RHSResearchLLC/PicoEVB/DMADriver/driver/readme.txt

The files in this directory provide Xilinx PCIe DMA drivers, example 
software, and example test scripts that can be used to exercise the 
Xilinx PCIe DMA IP. This software can be used directly or referenced 
to create drivers and software for your Xilinx FPGA hardware design.

Directory and file description:
 - driver/: This directory contains the Xilinx PCIe DMA kernel module
       driver files.
 - include/: This directory contain all include files that are needed
       for compiling driver.
 - etc/: This directory contains rules for the Xilinx PCIe DMA kernel
       module and software. The files in this directory should be
       copied to the /etc/ directory on your linux system.
 - tests/: This directory contains example application software to
       exercise the provided kernel module driver and Xilinx PCIe
       DMA IP. This directory also contains the following scripts 
       and directories.
   - load_driver.sh: This script loads the kernel module and creates
         the necissary kernel nodes used by the provided software.
         The The kernel device nodes will be created under /dev/xdma*.
         Additional device nodes are created under /dev/xdma/card* to
         more easily differentiate between multiple PCIe DMA enabled
         cards. Root permissions will be required to run this script.
   - run_test.sh: This script runs sample tests on a Xilinx PCIe DMA
         target and returns a pass (0) or fail (1) result. This 
         script is intended for use with the PCIe DMA example design.
   - data/: This directory contains binary data files that are used
         for DMA data transfers to the Xilinx FPGA PCIe endpoint 
         device.
   - scripts/: This directory contains test scripts that are
         referenced by the run_test.sh script.

Usage:
  - Change directory to the driver directory.
        cd driver
  - Compile the kernel module driver.
        make
  - Change directory to the tests directory.
        cd tests
  - Compile the provided example software.
        make
  - Copy the provided driver rules from the etc directory to the 
    /etc/ directory on your system.
        cp ../etc/udev/rules.d/* /etc/udev/rules.d/
  - Load the kernel module driver using the provided script.
        ./load_driver.sh
  - Run the provided test script to generate basic DMA traffic.
        ./run_test.sh

Updates and Backward Compaitiblity:
  - The following features were added to the PCIe DMA IP and driver 
    in Vivado 2016.1. These features cannot be used with PCIe DMA IP
    if the IP was generated using a Vivado build earlier than 2016.1.
      - Poll Mode: Earlier versions of Vivado only support interrupt
        mode which is the default behavior of the driver.
      - Source/Destination Address: Earlier versions of Vivado PCIe
        DMA IP required the low-order bits of the Source and 
        Destination address to be the same. As of 2016.1 this 
        restriction has been removed and the Source and Destination
        addresses can be any arbitrary address that is valid for
        your system.

Frequently asked questions:
  Q: How do I uninstall the kernel module driver?
  A: Use the following commands to uninstall the driver.
       - Uninstall the kernel module.
             rmmod -s xdma
       - Delete the dma rules that were added.
             rm -f /etc/udev/rules.d/60-xdma.rules
             rm -f /etc/udev/rules.d/xdma-udev-command.sh

  Q: How do I modify the PCIe Device IDs recognized by the kernel 
     module driver?
  A: The /driver/xdma-core.c file constains the pci_device_id struct 
     that identifies the PCIe Device IDs that are recognized by the
     driver in the following format:
         { PCI_DEVICE(0x10ee, 0x8038), },
     Add, remove, or modify the PCIe Device IDs in this struct as
     desired. Then uninstall the existing xdma kernel module, compile
     the driver again, and re-install the driver using the 
     load_driver.sh script.

  Q: By default the driver uses interupts to signal when DMA transfers
     are completed. How do I modify the driver to use polling rather
     than interrupts to determine when DMA transactions are completed?
  A: The driver can be changed from being interrupt driven (default)
     to being polling driven (poll mode) when the kernel module is
     inserted. To do this modify the load_driver.sh file as follows:
        Change: insmod ../driver/xdma.ko
        To:     insmod ../driver/xdma.ko poll_mode=1
     Note: Interrupt vs Poll mode will apply to all DMA channels. If 
     desired the driver can be modified such that some channels are 
     interrupt driven while others are polling driven. Refer to the 
     poll mode section of PG195 for additional information on using
     the PCIe DMA IP in poll mode. 

  Q: How can I enable debug in the kernel module driver to aid with
     driver development or debug?
  A: An XDMA_DEBUG define has been provided in the include/xdma-core.h
     file. To enable debug in the kernel module driver set this 
     #define to 1 as shown below.
         #define XDMA_DEBUG 1
     Then uninstall the existing xdma kernel module, compile the
     driver again, and re-install the driver using the load_driver.sh
     script.
