RHSResearchLLC/PicoEVB/images/pico-in-laptop-1_png_project-body-2.jpg

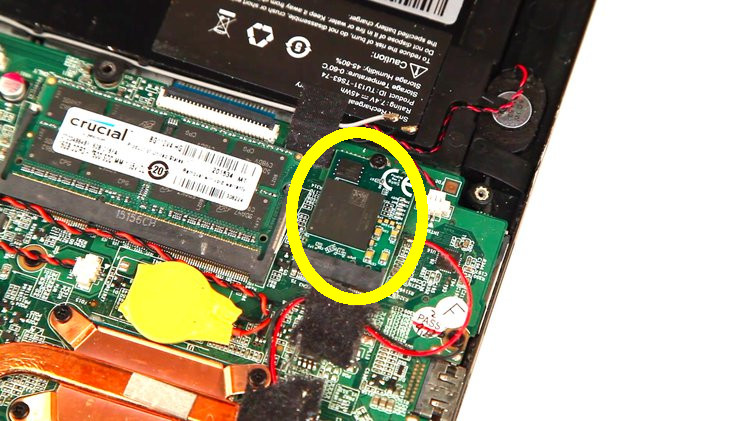
images/pico-in-laptop-1_png_project-body-2.jpg
