RHSResearchLLC/PicoEVB/images/vivado.png

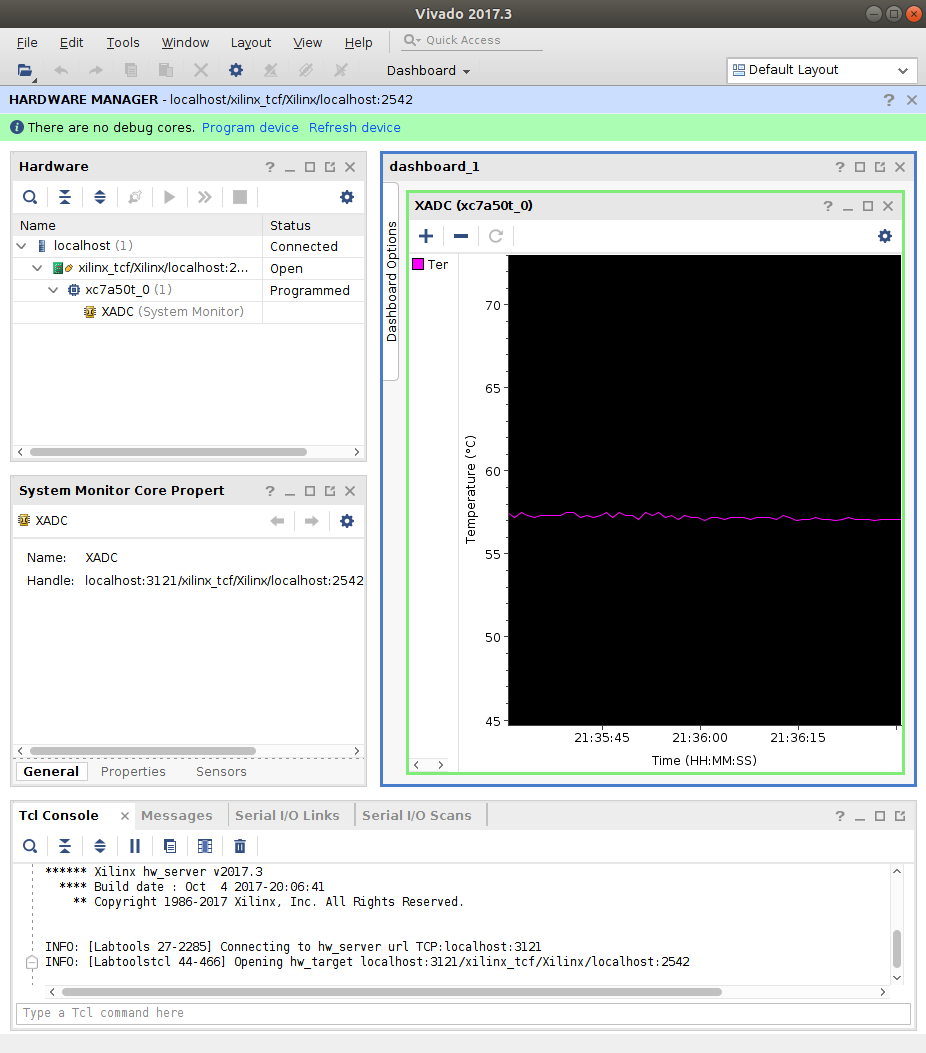
images/vivado.png
