RHSResearchLLC/PicoEVB/Hardware/board_design/PicoEVB.step

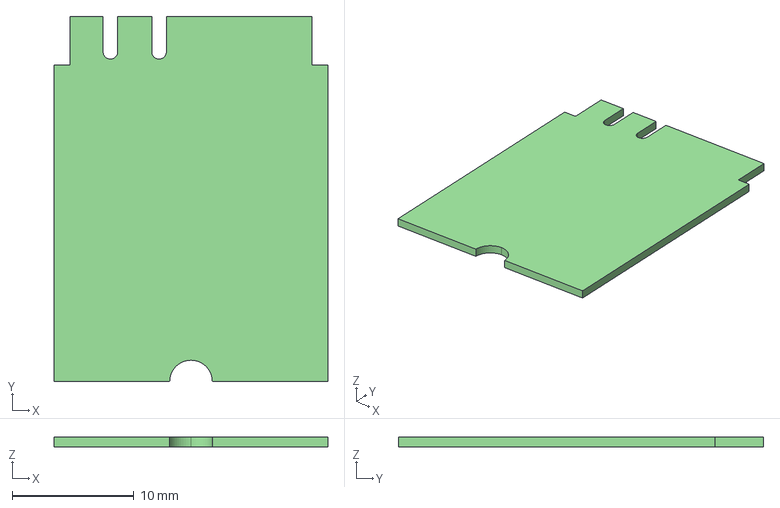
[picture p9: CAD file, 2025-12-04]
Hardware/board_design/PicoEVB.step
22.5 x 30.0 x 0.8 mm
