RHSResearchLLC/PicoEVB/(threads)

Thread 2 (2017-09-23):

Constraints map pin V11 - but it is N/C

joshrsmith, 2017-09-23:
Constraints map FPGA pin V11 to `status_leds[1]`, but this pin is NC in both picoEVB and nanoEVB.

RHSResearchLLC, 2018-01-12:
Fixed

Closed 2018-01-12.

Thread 4 (2018-01-02):

It would be great to add some samples how to use PicoEVB

hlide, 2018-01-02:
Now we have a Pico/NanoEVB, we may need some samples:

- How to read/write the host RAM through PCIe? suppose you want to make a guest [co]processor on the FPGA, you may want to reserve some host RAM for the guest [co]processor.
- How to share host RAM between guest (FPGA) and host (PC)?

RHSResearchLLC, 2018-01-09:
Hello hlide,

The Xilinx DMA core isn't exactly about sharing memory per se- its about transferring data between the host and FPGA at high speed. The Xilinx sample project has a good working demonstration of this and runs on NanoEVB/PicoEVB.

PCIe isn't really about shared memory, its about memory transfer. It seems shared because multiple clients can "access" it- but that access always consists of a transfer across the PCIe bus.

In your example (2), if the FPGA wants access to system RAM, it has to ask the PCIe system to transfer over a certain amount of data at a certain address. Likewise the FPGA can write into system RAM, but it still has to send a packet on the PCIe bus to do so. The FPGA has access to the RAM but it isn't like its a chip connected to the FPGA- you still need some real RAM in the FPGA to use as a reservoir.

The Xilinx DMA example demonstrates this:

- The host allocates some ram, and fills it with some data pattern.
- The host sends this data to the FPGA via PCIe; the data is transferred the data directly into the FPGA's BRAM
- The Host requests some data from the FPGA
- The FPGA transfers data from BRAM directly into host memory via PCIe

Granted the Xilinx example isn't super easy to follow. I could make a simpler, more explicit example.

hlide, 2018-01-11:
I know what DMA is and cannot be viewed as a direct RAM access. I asked you whether it was possible for the FPGA directly to address host RAM through PCIe before I decided to buy it (was my condition) and was kind of answered positively. But from what I can read above, there is no such possibility and a virtual RAM (a cache) is probably needed so the processor may not be impacted so much by the transfer timing between FPGA and Host through PCIe.

RHSResearchLLC, 2018-01-11:
Hello hlide,

It seems maybe I don't understand exactly what you mean. The FPGA does have
access to host memory. This access is implemented in Xilinx PCIe endpoint.
Xilinx provides an AXI interface to host memory. The sample project simply
transfers data from host memory to block ram. But you can make your own AXI
master to interface to Xilinx endpoint instead.

If you feel like you were deceived, or if this board can't do what you
need, shoot me an email (dave@nanoevb.com) so we can work it out. If you
want a refund, I will make good on it.

—
You are receiving this because you commented.
Reply to this email directly, view it on GitHub
<https://github.com/RHSResearchLLC/PicoEVB/issues/4#issuecomment-357039153>,
or mute the thread
<https://github.com/notifications/unsubscribe-auth/AbbnAI9F6OhpEP8PVvZU0J02MnlL0eSPks5tJmQ_gaJpZM4RQi_2>
.

hlide, 2018-01-11:
Suppose I want to add a soft processor with a virtual SRAM on the FPGA and that SRAM storage is provided by the host memory. So it is possible but you need a component which mimics an SRAM interface which is accessing the host memory through an AXI interface to host memory, right? So the issue is more with finding the right samples to show how to handle Xilinx endpoint to do that.

What I fear is there are no various samples which show how to program picoEMV for different tasks and so the product may remain unused. I had bought an MYIR Z-TURN ZYNQ 7020 long time ago and it remains in its box because there are no practical samples to learn how to use it efficiently in the end and I know several people in the same case with this board.

RHSResearchLLC, 2018-01-12:
Yes you are correct, you would need a component that has AXI on one side and SRAM-like interface on the other (with some type of wait signal to coordinate with the receipt of the data from the PCIe bus). I don't know of any samples out there that cover this.

hlide, 2018-01-12:
That's just an example.  I wonder if I can find a solution here: https://www.xilinx.com/products/intellectual-property/axi_pcie.html.

Thread 5 (2018-01-06):

Windows samples ?

hlide, 2018-01-06:
Seriously? that DMA sample for Linux is the only sample here?

RHSResearchLLC, 2018-01-09:
The DMA sample for Linux is only here because at the the time when this was developed, the version that Xilinx was hosting wouldn't build on Ubuntu-so I made some changes and hosted it here. Xilinx's code example builds on Windows, and works, no problem, as is.

https://www.xilinx.com/support/answers/65444.html

The DMA sample exercises the Xilinx DMA core in the HDL design. The HDL design also maps the physical I/O to registers-I'll be adding some host-side Python code soon to demonstrate that- but it is very simple.

What did you have in mind for sample projects?

hlide, 2018-01-11:
Mostly writing some processor cores, making some virtual computers - old systems or experimental systems (new cores). Incremental learning though. For this reason, I need to "steal" or share some resources like RAM to the host and some peripherals like storage and video may be on the host side (PC).

defparam, 2018-06-28:
Hi, I just posted an example of communicating to a PicoEVB device in Windows 10 using a UMDF2 driver example. Take a look here: https://github.com/defparam/BAR-Tender

RHSResearchLLC, 2018-06-28:
@defparam Very cool!

Thread 8 (2018-06-26):

Vivado board files

jeremytregunna, 2018-06-26:
I've looked high and low but I can't find any board files for the PicoEVB. Is this something planned or, not?

RHSResearchLLC, 2018-06-27:
Hi Jeremy,

Do you mean the PCB design files? If that is what you mean, I don't plan on releasing those. Besides the PCB, as designed, is a bit overkill (3 mil trace/space and via-in-pad) and expensive to manufacture.

jeremytregunna, 2018-06-27:
@RHSResearchLLC No I didn't mean the PCB design files, I meant the vivado specific files that would describe the board to Vivado such that it would show up in a list of boards when working in the design view to set up the clocks and external I/O

RHSResearchLLC, 2018-06-27:
@jeremytregunna Ahh OK. Sadly, I didn't know there was such a thing. That would be awesome. The closest thing I have is the [constraints file](https://github.com/RHSResearchLLC/PicoEVB/blob/master/Sample-Projects/Project-0/FPGA/constraints/xilinx_xdma_pcie_x0y0.xdc)

jeremytregunna, 2018-06-27:
@RHSResearchLLC Yeah I found that, and that's totally workable. I just went looking for board files while working on a test design for the new board (thanks btw, it's awesome for what it is). They're definitely not required just nice integration.

jeremytregunna, 2018-06-27:
Closing this then.

Closed 2018-06-27.

Thread 9 (2018-09-07):

Not able to connect using vivado Hardware manaager

shahbaazlokh, 2018-09-07:
Hello,

I have Picoevb attached to my motherboard via PCIe, I am not able to connect to it via Vivado Hardware manager. This is the message it shows.

WARNING: [Labtoolstcl 44-27] No hardware targets exist on the server [localhost:3121]
Check to make sure the cable targets connected to this machine are properly connected
and powered up, then use the refresh_hw_server command to re-register the hardware targets.

I am not able to understand this line in Readme file
First, make sure xvcd cable driver is running. Build the xvcd project, then run
`sudo ./xvcd -p 2542 -s i:0x0403:0x6015:0`

Please explain.
Thanks and Regards

shahbaazlokh, 2018-09-10:
Followed the steps guided in Readme file and the problem is solved,
Thanks

Closed 2018-09-10.

Thread 10 (2018-12-14):

Update on order status

fischer, 2018-12-14:
Hi,

On Dec 5, 2018 my Visa shows a debit for two PicoEVB boards that I ordered.  I didn't find any email confirming the order.  I didn't find an email with shipping information.  I didn't find a way to contact you via the picoevb.com website.  Can someone please post an email address so I can get an update on my order.

Thanks,

Todd Fischer
RidgeRun

Closed 2019-01-08.

Thread 11 (2019-02-13):

Copyright history of xilinx_xdma_pcie_x0y0.xdc

swarren, 2019-02-13:
The file PicoEVB/Sample-Projects/Project-0/FPGA/xilinx_xdma_pcie_x0y0.xdc contains:
## (c) Copyright 2012-2012 Xilinx, Inc. All rights reserved.

I'd like to create a project for PicoEVB, and want to re-use this .xdc file. However, I can't do it with the current license. Can you please tell me where you got the original file, and which parts you added yourself as opposed to found in the original, so I can research the licensing?

Thanks.

RHSResearchLLC, 2019-11-20:
Sorry for the extremely late response. Yes that file was autogenerated by Vivado, which it why the restrictive copyright. I was lazy and just copied their output and added PicoEVB-specific stuff.

The solution is to delete all the XDMA-specific stuff (Vivado makes its own constraint file for this anyway), and as such delete the copyright as well. When I update the project next I'll do this

swarren, 2019-11-20:
Thanks; that's what I figured. You might find https://github.com/NVIDIA/jetson-rdma-picoevb/tree/master/fpga useful as a reference; it allows using git with Vivado without having to check in all the generated stuff.

Closed 2020-07-22.

Thread 12 (2019-03-13):

Failed to detect XDMA config BAR

brooksbp, 2019-03-13:
I'm having trouble getting the sample project to work out of the box.

When using Xilinx_Answer_65444_Linux_Files_rel20180420.zip, I get this:

```
[635799.492540] xdma:xdma_mod_init: Xilinx XDMA Reference Driver xdma v2017.1.47
[635799.492542] xdma:xdma_mod_init: desc_blen_max: 0xfffffff/268435455, sgdma_timeout: 10 sec.
[635799.492563] xdma:xdma_device_open: xdma device 0000:04:00.0, 0x00000000fd37877b.
[635799.492564] xdma:alloc_dev_instance: xdev = 0x000000007df08759
[635799.492565] xdma:xdev_list_add: dev 0000:04:00.0, xdev 0x000000007df08759, xdma idx 0.
[635799.492642] xdma:pci_check_extended_tag: 0x00000000fd37877b EXT_TAG disabled.
[635799.492643] xdma:pci_check_extended_tag: pdev 0x00000000fd37877b, xdev 0x000000007df08759, config bar UNKNOWN.
[635799.492650] xdma:request_regions: pci_request_regions()
[635799.492652] xdma:map_single_bar: BAR0: 1048576 bytes to be mapped.
[635799.492679] xdma:map_single_bar: BAR0 at 0xdf300000 mapped at 0x00000000a16149d0, length=1048576(/1048576)
[635799.492683] xdma:is_config_bar: BAR 0 is NOT the XDMA config BAR: 0xffffffff, 0xffffffff.
[635799.492683] xdma:map_single_bar: BAR2: 65536 bytes to be mapped.
[635799.492691] xdma:map_single_bar: BAR2 at 0xdf400000 mapped at 0x0000000095d37002, length=65536(/65536)
[635799.492694] xdma:is_config_bar: BAR 2 is NOT the XDMA config BAR: 0xffffffff, 0xffffffff.
[635799.492695] xdma:map_bars: Failed to detect XDMA config BAR
[635799.517276] xdma: probe of 0000:04:00.0 failed with error -22
```

How could reading the config registers (PG195) from the BAR fail and return all ones?

brooksbp, 2019-03-15:
After programming the bitstream, I had to:

```
# echo 1 > /sys/bus/pci/devices/0000\:03\:00.0/remove
# echo 1 > /sys/bus/pci/rescan
```

Previously, I was just doing the rescan without removing the device. Removing the device before the rescan is necessary.

makslevental, 2022-02-07:
Not sure why it occurred for @brooksbp but it occurs for me as well when I ditch the xadc module. Luckily someone has had this same issue and posted about it over on the [Xilinx forums](https://support.xilinx.com/s/question/0D52E00006hpQezSAE/config-bar-not-detected-in-xdma-driver?language=en_US). Since Xilinx's forums have spotty uptime (and sometimes the posts straight up vanish), I'm copy+pasting here:

 >[dakota111](https://support.xilinx.com/s/profile/0052E00000N3gJNQAZ) (Customer)

9 months ago
**BEST SOLUTION**
Ok, so I THINK I have an idea why BAR2 IRQ ID is returning all 0xF. If you have time to try it out, please let me know how it works out.
I modified the picoevb image to remove the XADC block because I did not want it.
The side effect of that was now there is no valid block behind 0x3000 on the AXI lite bus (BAR0).
When the XDMA driver reads ID registers to figure out what BAR is the config BAR, it does it in the following order:
* BAR0 IRQ ID at BAR0\+0x2000: access to axi_gpio_1 successfully
* BAR0 CFG ID at BAR0\+0x3000: access to NULL fails
* BAR2 IRQ ID at BAR0\+0x2000: access to xdma reg BUT returns invalid value from NULL read
* BAR2 CFG ID at BAR0\+0x3000: access to xdma reg successfully
To fix this, I modifed xdma/libxdma.c to read BAR2 IRQ ID twice to flush out the error

Closed 2019-03-15.

Thread 13 (2019-05-14):

(Sample project) Updating IPs leads to a failure in communication with the PicoEVB

CedricDly, 2019-05-14:
Hi,
I'm facing an issue when I try to compile and use the Sample Project given in the Github repository. When opening the project in Vivado 2018.3, the IP Upgrade results in a Critical Warning, telling me to look at a log file in order to fix. Here is the warning section of the log:

```
2. Customization warnings
-------------------------

Parameter 'pf1_expansion_rom_size_mqdma' is no longer present on the upgraded IP 'project_bd_xdma_0_0', and cannot be set to '2'
Parameter 'pf0_expansion_rom_size_mqdma' is no longer present on the upgraded IP 'project_bd_xdma_0_0', and cannot be set to '2'
Parameter 'pf2_expansion_rom_enabled_mqdma' is no longer present on the upgraded IP 'project_bd_xdma_0_0', and cannot be set to 'false'
Parameter 'pf1_expansion_rom_enabled_mqdma' is no longer present on the upgraded IP 'project_bd_xdma_0_0', and cannot be set to 'false'
Parameter 'pf0_expansion_rom_scale_mqdma' is no longer present on the upgraded IP 'project_bd_xdma_0_0', and cannot be set to 'Kilobytes'
Parameter 'pf2_expansion_rom_scale_mqdma' is no longer present on the upgraded IP 'project_bd_xdma_0_0', and cannot be set to 'Kilobytes'
Parameter 'pf0_expansion_rom_enabled_mqdma' is no longer present on the upgraded IP 'project_bd_xdma_0_0', and cannot be set to 'false'
Parameter 'pf3_expansion_rom_type_mqdma' is no longer present on the upgraded IP 'project_bd_xdma_0_0', and cannot be set to 'N/A'
Parameter 'pf2_expansion_rom_type_mqdma' is no longer present on the upgraded IP 'project_bd_xdma_0_0', and cannot be set to 'N/A'
Parameter 'pf1_expansion_rom_type_mqdma' is no longer present on the upgraded IP 'project_bd_xdma_0_0', and cannot be set to 'N/A'
Parameter 'pf0_expansion_rom_type_mqdma' is no longer present on the upgraded IP 'project_bd_xdma_0_0', and cannot be set to 'N/A'
Parameter 'pf1_expansion_rom_scale_mqdma' is no longer present on the upgraded IP 'project_bd_xdma_0_0', and cannot be set to 'Kilobytes'
Parameter 'pf3_expansion_rom_scale_mqdma' is no longer present on the upgraded IP 'project_bd_xdma_0_0', and cannot be set to 'Kilobytes'
Parameter 'pf3_expansion_rom_size_mqdma' is no longer present on the upgraded IP 'project_bd_xdma_0_0', and cannot be set to '2'
Parameter 'pf3_expansion_rom_enabled_mqdma' is no longer present on the upgraded IP 'project_bd_xdma_0_0', and cannot be set to 'false'
Parameter 'pf2_expansion_rom_size_mqdma' is no longer present on the upgraded IP 'project_bd_xdma_0_0', and cannot be set to '2'
```

Despite this critical warning, the bitstream is compiled but when flashed to the PicoEVB, it does not work as it should. Here is a result of the "xdma_info" command:
```
Found 1 XDMA devices
device path:    \\?\pci#ven_10ee&dev_7021&subsys_000710ee&rev_00#4&97078f1&0&00e4#{74c7e4a9-6d5d-4a70-bc0d-20691dff9e9d}
unknown Module
unknown Module
unknown Module
unknown Module
unknown Module
unknown Module
unknown Module
```

Any advice on how to solve this issue ? Should I downgrade my Vivado version ?

jackpot51, 2019-09-25:
I would also like to know how to update the sample project successfully - I am on Vivado 2019.1.3

Hallb3rg, 2019-10-07:
I'm also struggling with this a bit now.

The critical warning messages seem to come from a name change of a variable, and may be unrelated.

In Windows the "unknown module" is resolved after either re-installing the driver or rebooting the PC.
In case the power is cycled on the PCIe card during reboot you need to make sure you have written the bitstream to flash.
After this the xdma_info worked....almost....

Now I get data mismatch running the DMA tests ( in both Linux and windows).
Sometimes xdma_info stops working again, and Windows crashes completely.
I'm thinking it may be timing related since it is just some of the data that is wrong, and at different positions each run.

Hugh3226, 2019-11-06:
I'm struggling too.
Have tried Vivado 2017.3 and 2019.1

Vivado v2017.3 (64-bit)
SW Build: 2018833 on Wed Oct 4 19:58:22 MDT 2017
IP Build: 2016188 on Wed Oct 4 21:52:56 MDT 2017

Vivado v2019.1 (64-bit)
SW Build: 2552052 on Fri May 24 14:49:42 MDT 2019
IP Build: 2548770 on Fri May 24 18:01:18 MDT 2019

RHSResearchLLC, 2019-11-20:
I'm working on updated sample project which uses Vivado 2019, and Xilinx latest drivers (https://github.com/Xilinx/dma_ip_drivers). This sample project will also have a tool to program the flash over PCIe, which is much faster. Stay tuned

RHSResearchLLC, 2019-11-21:
OK latest design (EVB4) fixes these problems. Issue is Xilinx "new" driver doesn't like "user" stuff at low addresses. Moved I/O addresses up to 0x1000 and higher.

Closed 2019-11-21.

Thread 14 (2019-09-25):

Extremely long programming time

langfordpang, 2019-09-25:
I'm having trouble programming MCS file to flash. Basically, after I run prog-fpga.tcl, it takes more than 8 hrs *elapsed time* to program the flash, while the *CPU time* is just a few minutes. I am not even sure if the flash is correctly programmed after 8 hrs because all I have right now is the MCS file from the master branch, which I believe is the same one as default.

I am using CentOS 7.6 and Vivado 2018.3, which I don't believe makes a difference in this case. I thought about other possibilities are USB device busy(?) or JTAG speed too low(?) but none of them make sense. I cannot explain. Please advise.

langfordpang, 2019-09-25:
Follow up on this issue -
1) tried another image using different chip ID and confirmed the image can be successfully programmed. But it takes the same amount of time (8+hrs)
2) while building XVCD, it failed to find function ftdi_write_data_async. I searched in the header file and library and no such a symbol. I also failed to find a reliable source online to build myself. So I removed the ASYNC macro. I guess this could be the reason. If it’s true, can you advise how I should get over this? Thank you.

RHSResearchLLC, 2019-11-20:
Normal programming time is 20 minutes, which isn't great but better than 8hr. You can try an executable I pre-built for Linux: https://github.com/RHSResearchLLC/xvcd/blob/master/linux/bin/xvcd

It depends on a few libraries:
```
linux-vdso.so.1 (0x00007fffe7969000)
	libftdi.so.1 => /usr/lib/x86_64-linux-gnu/libftdi.so.1 (0x00007f32c195f000)
	libc.so.6 => /lib/x86_64-linux-gnu/libc.so.6 (0x00007f32c156e000)
	libusb-0.1.so.4 => /lib/x86_64-linux-gnu/libusb-0.1.so.4 (0x00007f32c1365000)
	/lib64/ld-linux-x86-64.so.2 (0x00007f32c1d6b000)
```

resinbeard, 2019-12-18:
As a data point, my programming time takes 28min

RHSResearchLLC, 2020-11-30:
Just added https://github.com/RHSResearchLLC/PicoEVB/tree/master/spi-flash-program-openocd. This can program the entire flash in under 5 minutes. The sample project programs in 2 minutes.

makslevental, 2022-02-05:
@RHSResearchLLC sorry for the n00b question, but for our own projects, what do we replace in `flash.cfg`? i.e. here

```
jtagspi_init 0 bscan_spi_xc7a50t.bit
jtagspi_program image.bin 0x0
```
do we replace `bscan_spi_xc7a50t.bit` or `image.bin` with the corresponding files produced by vivado? I actually tried both permutations and replacing `bscan_spi_xc7a50t.bit` got me the same behavior as the example, and the inverse didn't successfully flash.

RHSResearchLLC, 2022-02-09:
You'd replace image.bin with an output from vivado- flash image in binary
format

On Sat, Feb 5, 2022 at 2:57 PM Maksim Levental ***@***.***>
wrote:

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

Thread 15 (2019-10-29):

Not coming out of reset on ARM (iMX6) devices

AndyCapp69, 2019-10-29:
I have tried the PicoEVB in several different types of iMX6 and the PicoEVB never comes out of reset (all LEDS on constant). I have tried modifying the PCI driver (pci-imx6.c) to extend the delays for clock stabilisation etc and even tried inverting the reset signal.  Using a scope I can see the reset line is being controlled. It does work on a Linux or Windows PC. Has anybody ever seen this working on an ARM system?

tschaar, 2019-10-29:
I have the PicoEVB working successfully with a Jetson Xavier dev kit.

Hugh3226, 2019-11-06:
I had the same problem.
The motherboard I use had an inverting open drain transistor on the reset line. Also a 100K pull-up and 22pF capacitor to deck.
I removed the capacitor and reduced the pull-up to 1K ohm.
We are using an iMX6.
Regards

RHSResearchLLC, 2019-11-20:
Thanks for reporting

Closed 2019-11-20.

Thread 16 (2019-11-21):

pcie recognition problems

starkten, 2019-11-21:
I've recently bought the PicoEVB board and adapter to connect it via mPCIe port. Right now I'm trying to program ARTIX with my own project being written through xapp1052, but I have some difficulties with misunderstanding output signal behavior as i use verilog ordinary. Is it neccessary to use W_DISABLE0, W_DISABLE1 placed on 56 and 54 pins of M2 port or should PC recognise PCIe device without it correctly? Thanks for your help.

RHSResearchLLC, 2019-11-26:
Hello starkten,
The W_DISABLE0 and W_DISABLE1 pins are simply input to the FPGA- they have no impact on FPGA/PCIe recognition and can be ignored.

The factory bitstream doesn't work well with the latest Xilinx drivers. If you are using Xilinx drivers from their GitHub, please load new bitstream 'EVB4' from https://github.com/RHSResearchLLC/PicoEVB/tree/master/Sample-Projects/Project-0/FPGA/mcs.

If you are using the "old" drivers (like the drivers I forked), the factory bitstream should work fine.

Closed 2020-01-16.

Thread 17 (2020-06-10):

SPI NOR Flash "S25FL132K0XNFIQ11" obsolete?

LuckyPi, 2020-06-10:
The SPI NOR Flash "S25FL132K0XNFIQ11" included in the BOM is showing as obsolete on Mouser & Digi-Key.  Do you have a recommended alternative that will work with the sip-loader? Thanks!

RHSResearchLLC, 2020-06-13:
I have a large cache of S25FL123K, so for the next year (at least) PicoEVB will be built with this flash. If I do change the flash part, I'll update spi-loader to support the new flash.

There are several flash parts that work with the XC7A50T part. See Xilinx UG908 appendix C.

Closed 2020-06-13.

Thread 18 (2020-07-22):

spi_loader fails on verify

RHSResearchLLC, 2020-07-22:
SPI loader successfully writes flash, but fails on verify phase. spi_loader needs to be fixed to account for dummy cycles on read

p0llard, 2020-07-25:
Out of interest, does this occur at random, or is there a reliable way to reproduce this issue? I've been using the `spi_loader` program quite a bit without any issues,

RHSResearchLLC, 2020-07-25:
It appears that the code does indeed account for dummy cycles on read. Not sure what i was thinking.

Thread 19 (2021-11-10):

Example Program doesn't appear to work

lucasbanting, 2021-11-10:
The example program appears to have been update to vivado 2020.1.
Vivado 2020.1 has a bug: https://support.xilinx.com/s/article/75502?language=en_US

When I try to generate the block design for the sample project, I get the error:
[BD 41-237] Bus Interface property FREQ_HZ does not match between /xadc_wiz_0/s_axi_lite(100000000) and /axi_interconnect_0/xbar/M02_AXI(125000000)

Which appears to be related to the aforementioned Vivado bug. Does anyone have a currently working configuration they are using that works with the sample project?

RHSResearchLLC, 2021-11-13:
I haven't yet updated the project to Vivado 2021. If you open in Vivado 2021, it should auto-update.

lucasbanting, 2021-11-16:
For what it is worth I am running on an unsupported OS, but after pulling the last git commit 3 days ago I can now synthesize the project successfully. I am using vivado 2021.2, not 2021.1.

The only message I found when upgrading the IP's was:

2. Customization warnings
-------------------------

An attempt to modify the value of disabled parameter 'pf1_msix_cap_table_size' from '000' to '01F' has been ignored for IP 'project_bd_xdma_1_0'

An attempt to modify the value of disabled parameter 'pf1_msix_cap_table_offset' from '00000000' to '00009000' has been ignored for IP 'project_bd_xdma_1_0'

An attempt to modify the value of disabled parameter 'pf1_msix_cap_pba_offset' from '00000000' to '00009FE0' has been ignored for IP 'project_bd_xdma_1_0'

Should these be values be re-customized to remove the warning?

Thread 21 (2022-04-10):

Mating connector for 6-pin digital interface

FlashPackets, 2022-04-10:
Please provide a part number for the 6-pin digital interface.

FlashPackets, 2022-04-10:
Found it in the board docs. Molex Pico-EZMate

Thread 22 (2024-11-16):

Key type?

Erhannis, 2024-11-16:
I'm pretty new to M.2 devices, so maybe I have a fundamental misunderstanding here, but: how hard would it be to make this fit an m key slot?  I have a new laptop, saw it had two extra M.2 2230 slots, and thought, "Oh, maybe I'll put something cool in one, like an FPGA."  The laptop documentation didn't say what key type they were (though people in-the-know may have noticed it was in the "storage" section of the documentation), couldn't find anything about it, so I figured key type must be one of those things that doesn't matter much in practice.  Bought a PicoEVB off Amazon.  Nope!  Doesn't fit.  Apparently I can _replace my wifi card_ with it, but haha, I need my wifi card.  How difficult would it be to refactor the card to fit an m key slot?  A matter of moving a few pins, of swapping around some components, of redesigning the entire board, or of subverting the entire system of M.2 types?
