RHSResearchLLC/PicoEVB/Hardware/PicoEVB-D.pdf

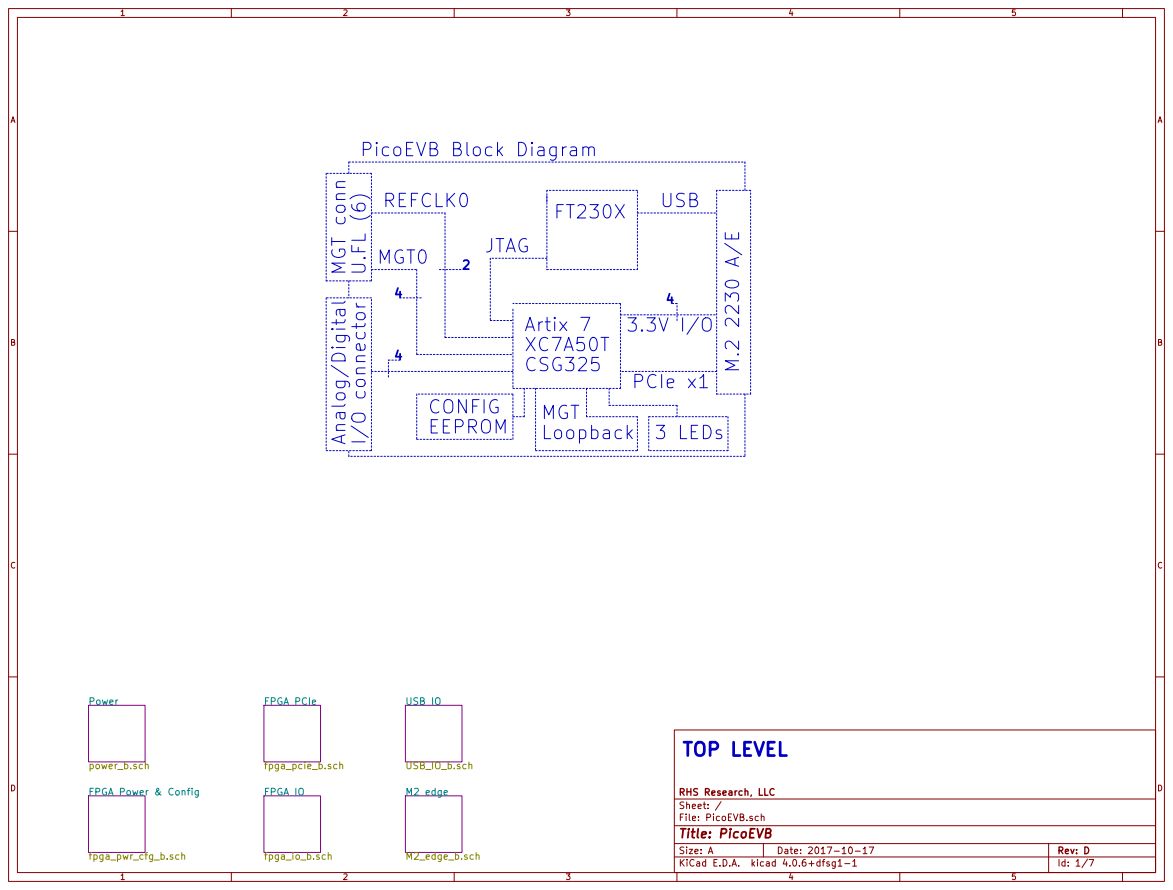
[picture p10: page 1]

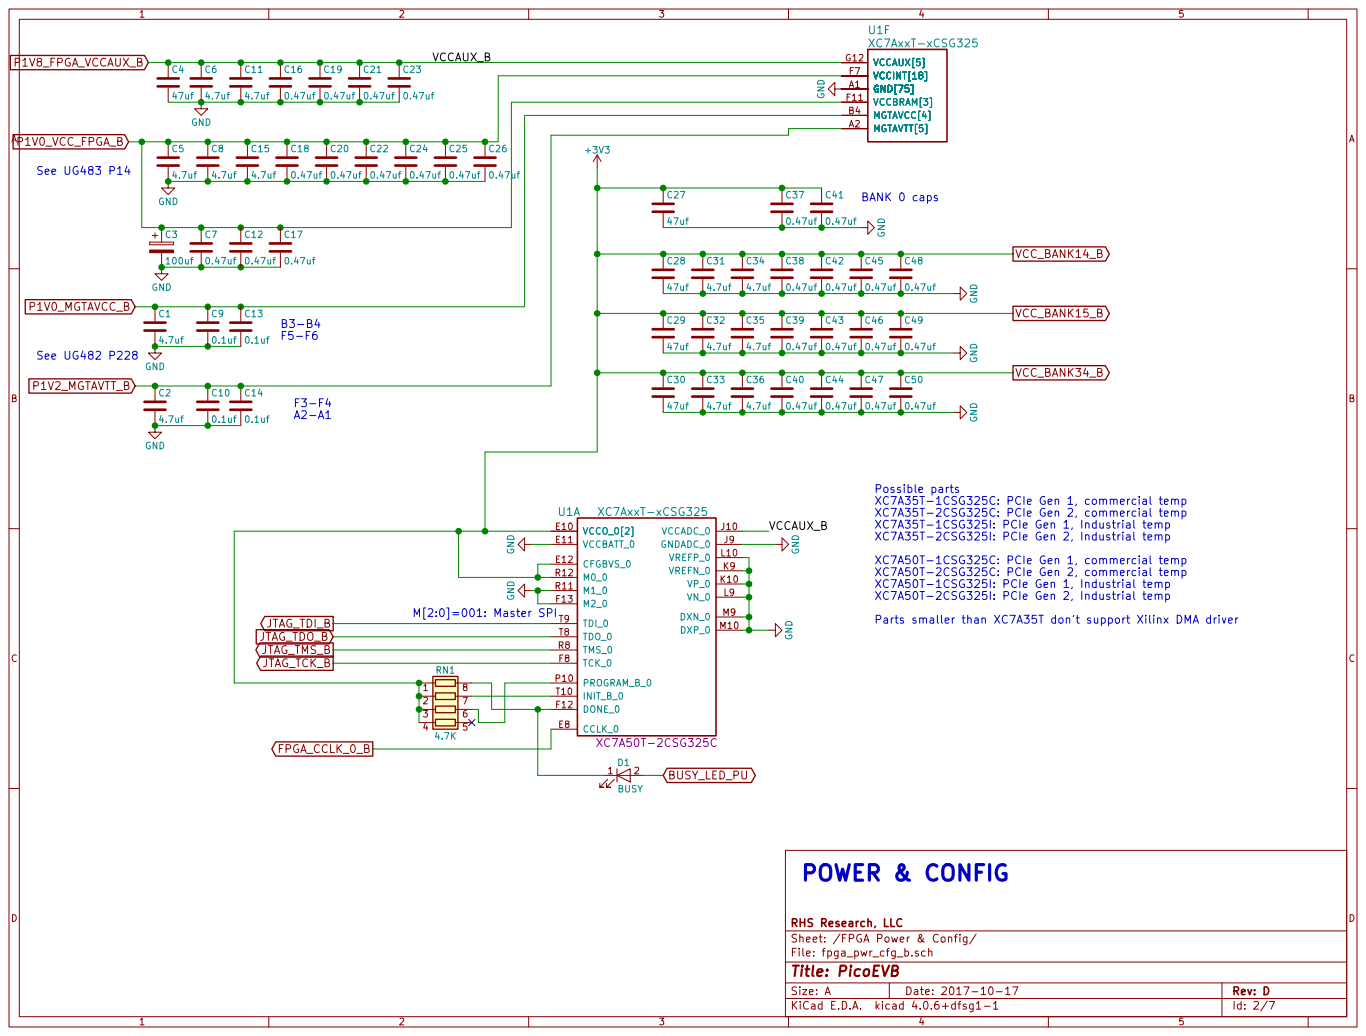
[picture p11: page 2]

+3V3 GND GND GND GND

Possible parts
XC7A35T-1CSG325C: PCIe Gen 1, commercial temp
XC7A35T-2CSG325C: PCIe Gen 2, commercial temp
XC7A35T-1CSG325I: PCIe Gen 1, Industrial temp
XC7A35T-2CSG325I: PCIe Gen 2, Industrial temp
XC7A50T-1CSG325C: PCIe Gen 1, commercial temp
XC7A50T-2CSG325C: PCIe Gen 2, commercial temp
XC7A50T-1CSG325I: PCIe Gen 1, Industrial temp
XC7A50T-2CSG325I: PCIe Gen 2, Industrial temp
Parts smaller than XC7A35T don't support Xilinx DMA driver

RHS Research, LLC
Sheet: /FPGA Power & Config/
File: fpga_pwr_cfg_b.sch
Id: 2/7 Title: PicoEVB

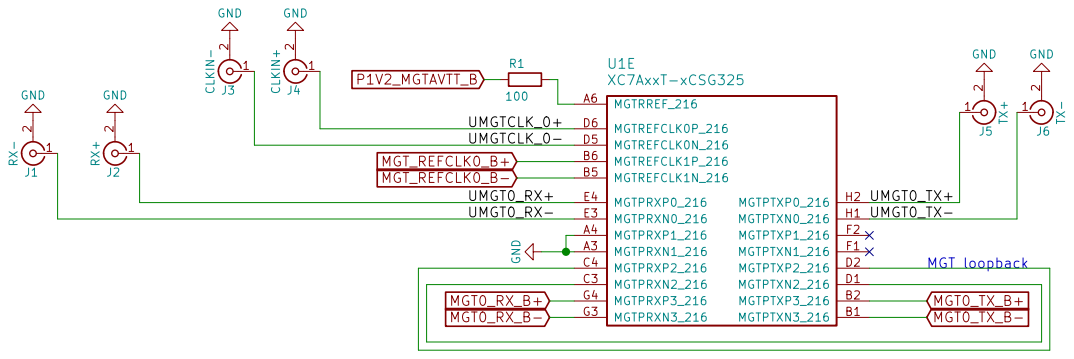
[picture p12: page 3]

PCI Express / MGT loopback

File: fpga_pcie_b.sch Sheet: /FPGA PCIe/ RHS Research, LLC

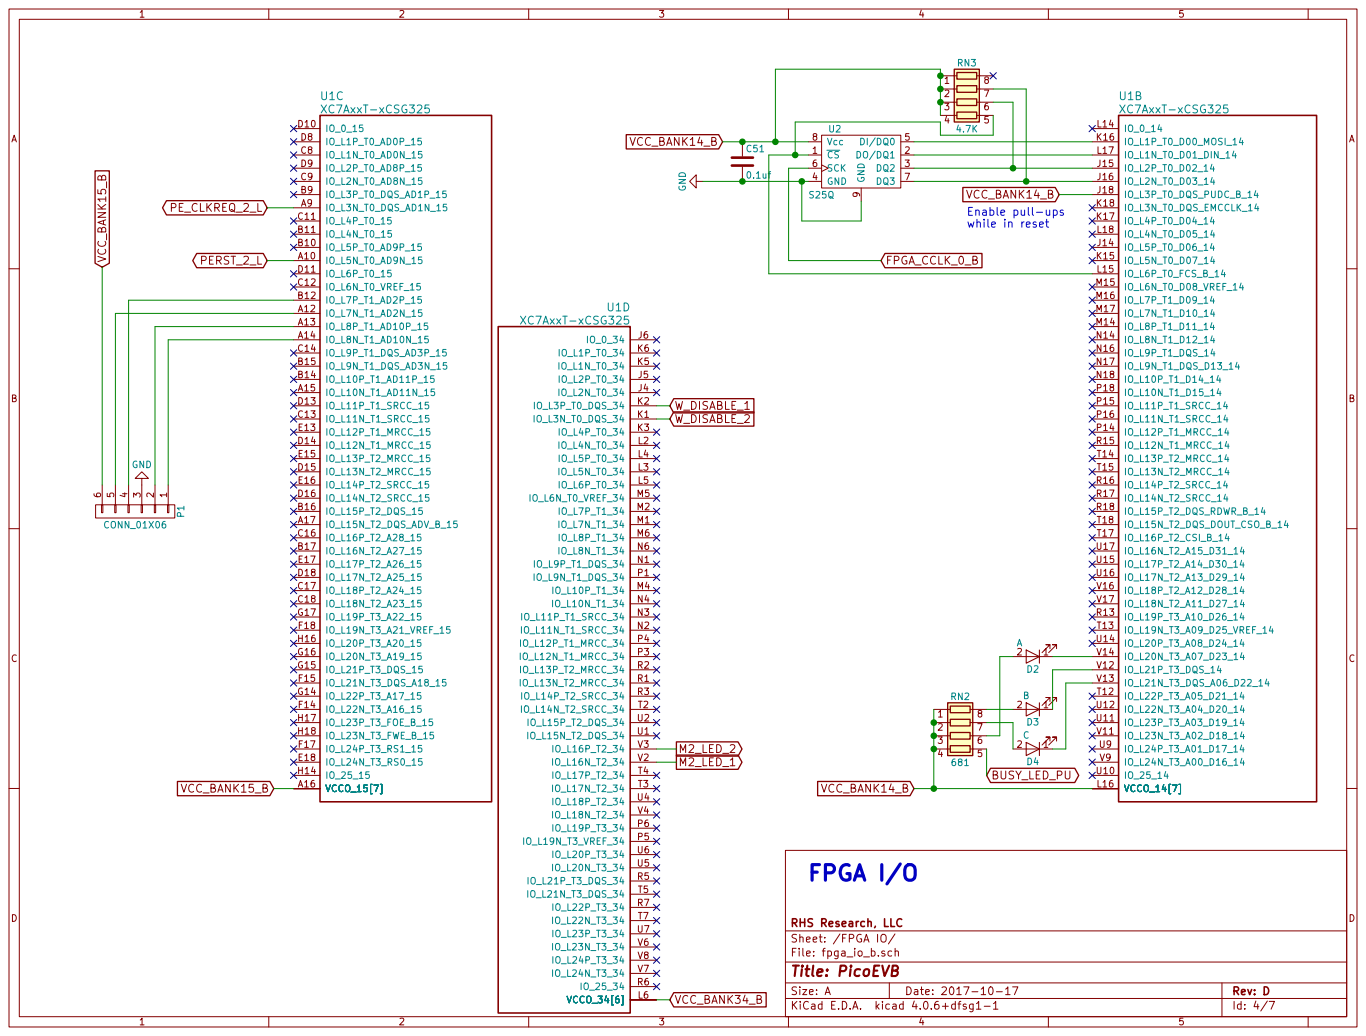
[picture p13: page 4]

File: fpga_io_b.sch Sheet: /FPGA IO/ RHS Research, LLC

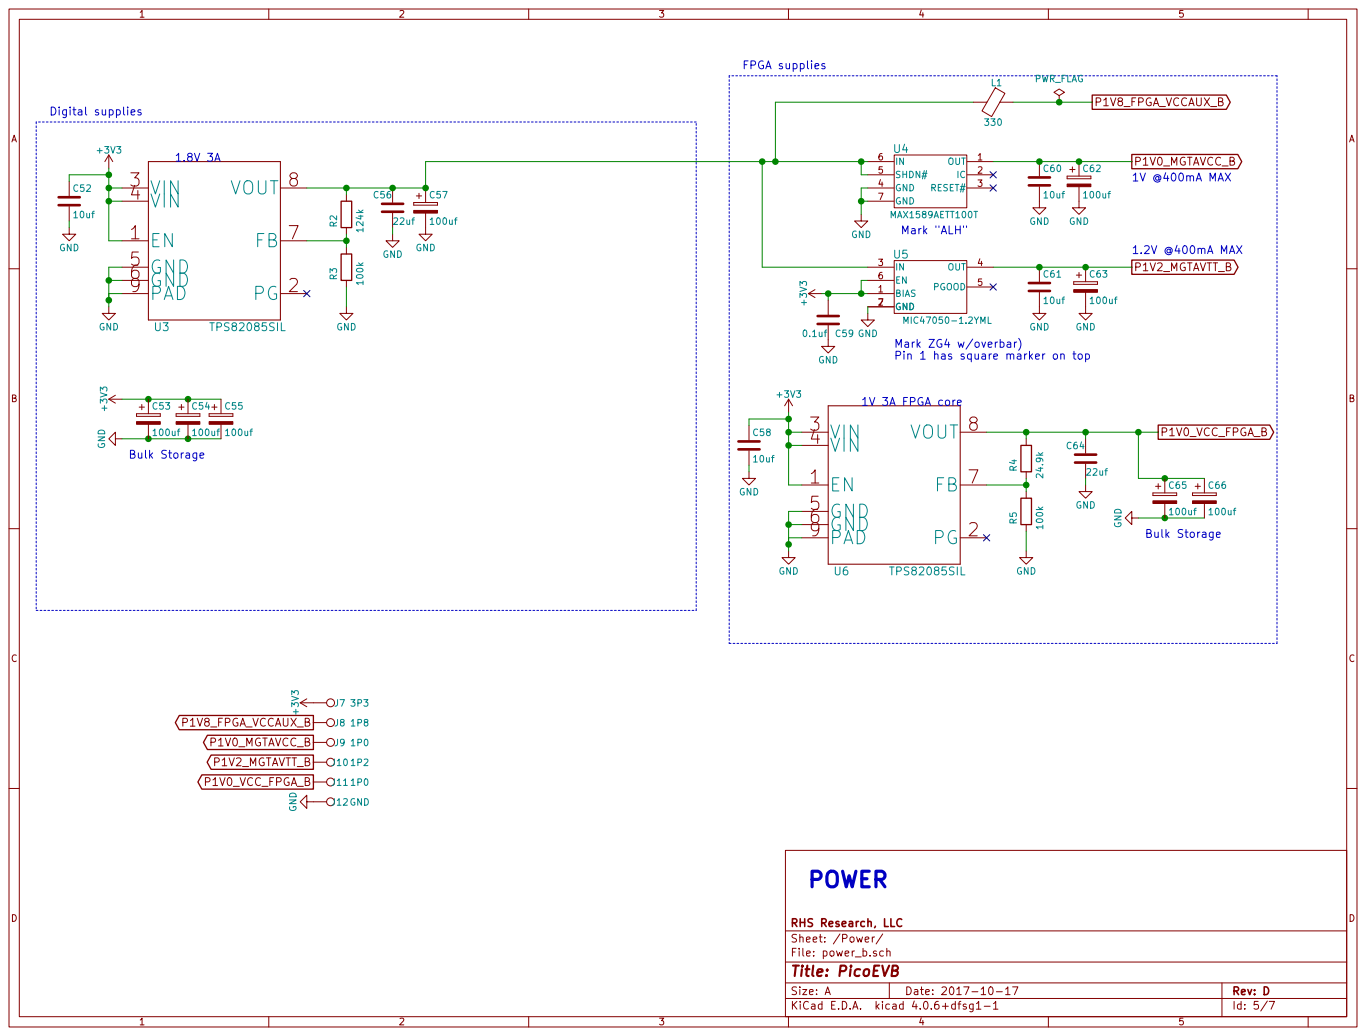
[picture p14: page 5]

Pin 1 has square marker on top

File: power_b.sch Sheet: /Power/ RHS Research, LLC

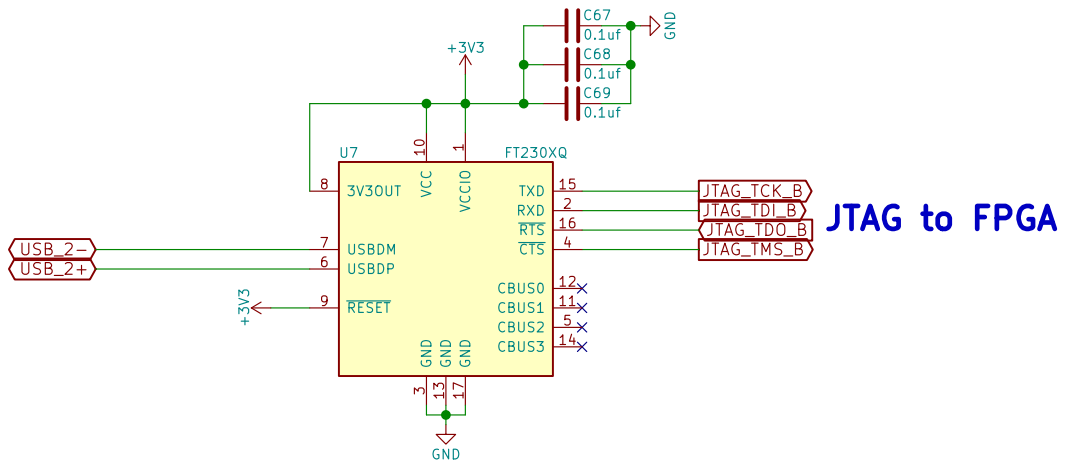
[picture p15: page 6]

1 RXD 2 GND
JTAG to FPGA VCCIO

USB-based JTAG cable

File: USB_IO_b.sch Sheet: /USB IO/ RHS Research, LLC

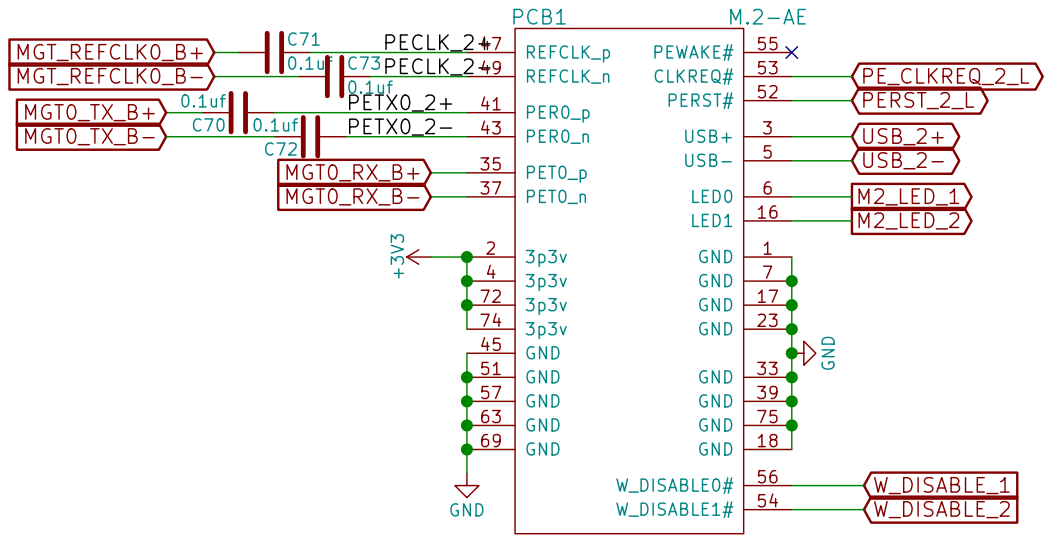
[picture p16: page 7]

RHS Research, LLC GND +3V3
