RHSResearchLLC/PicoEVB/Hardware/board_design/PicoEVB.kicad_pcb

## KiCad design Hardware/board_design/PicoEVB.kicad_pcb (2018-11-11)

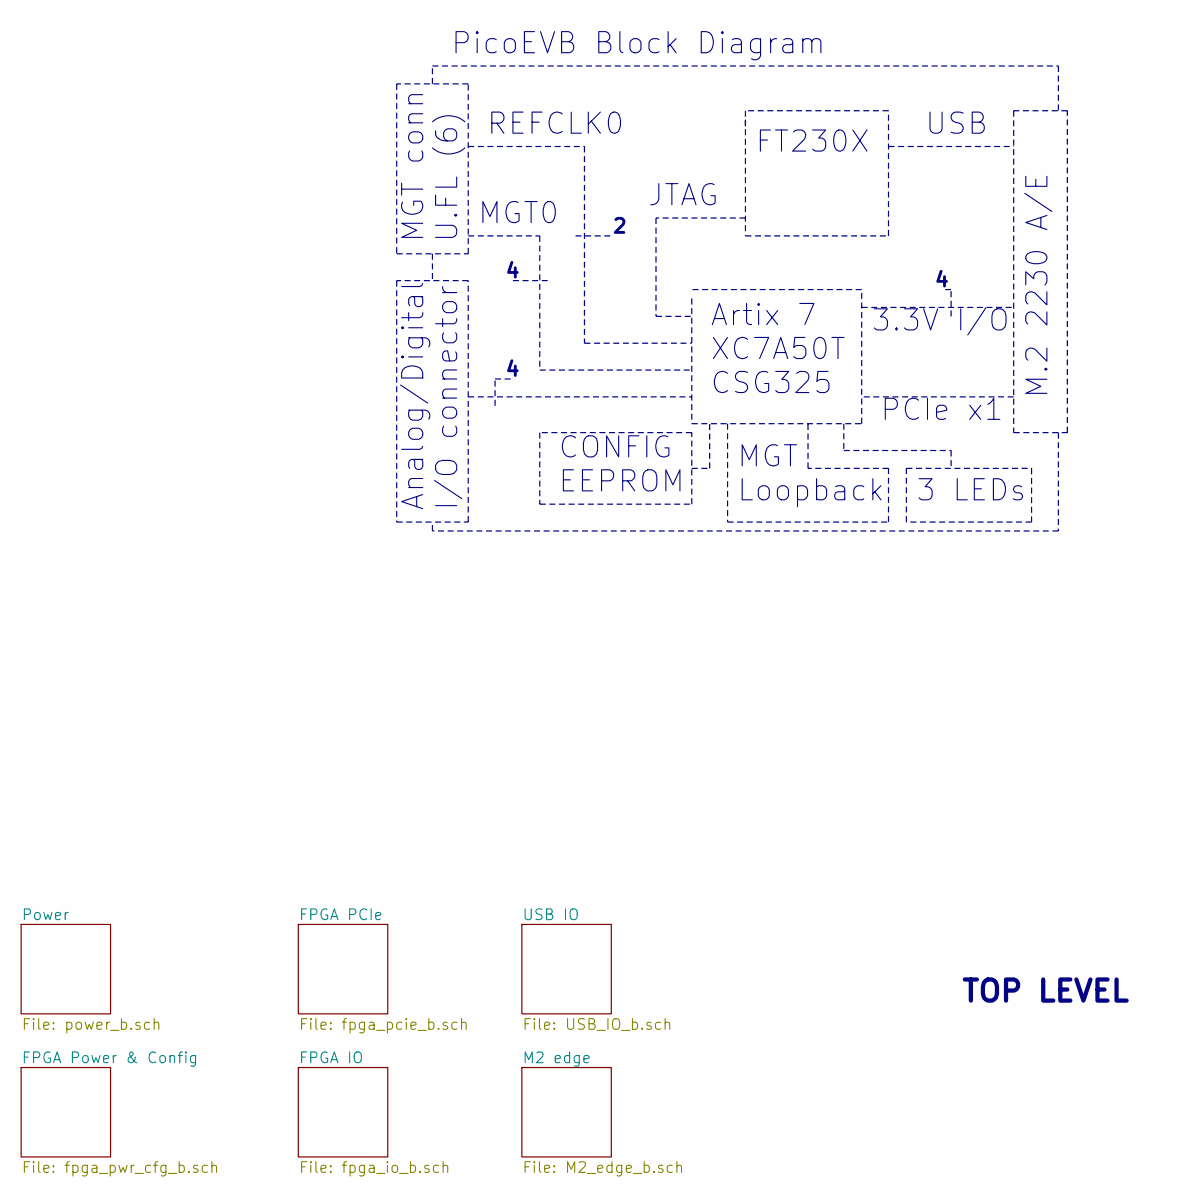
[picture p17: schematic PicoEVB.sch]

Notes on the sheet:
TOP LEVEL
M.2 2230 A/E
FT230X
USB
Artix 7 XC7A50T CSG325
PCIe x1
JTAG
MGT Loopback
Analog/Digital I/O connector
PicoEVB Block Diagram
3 LEDs
CONFIG EEPROM
MGT conn U.FL (6)
MGT0
REFCLK0
3.3V I/O

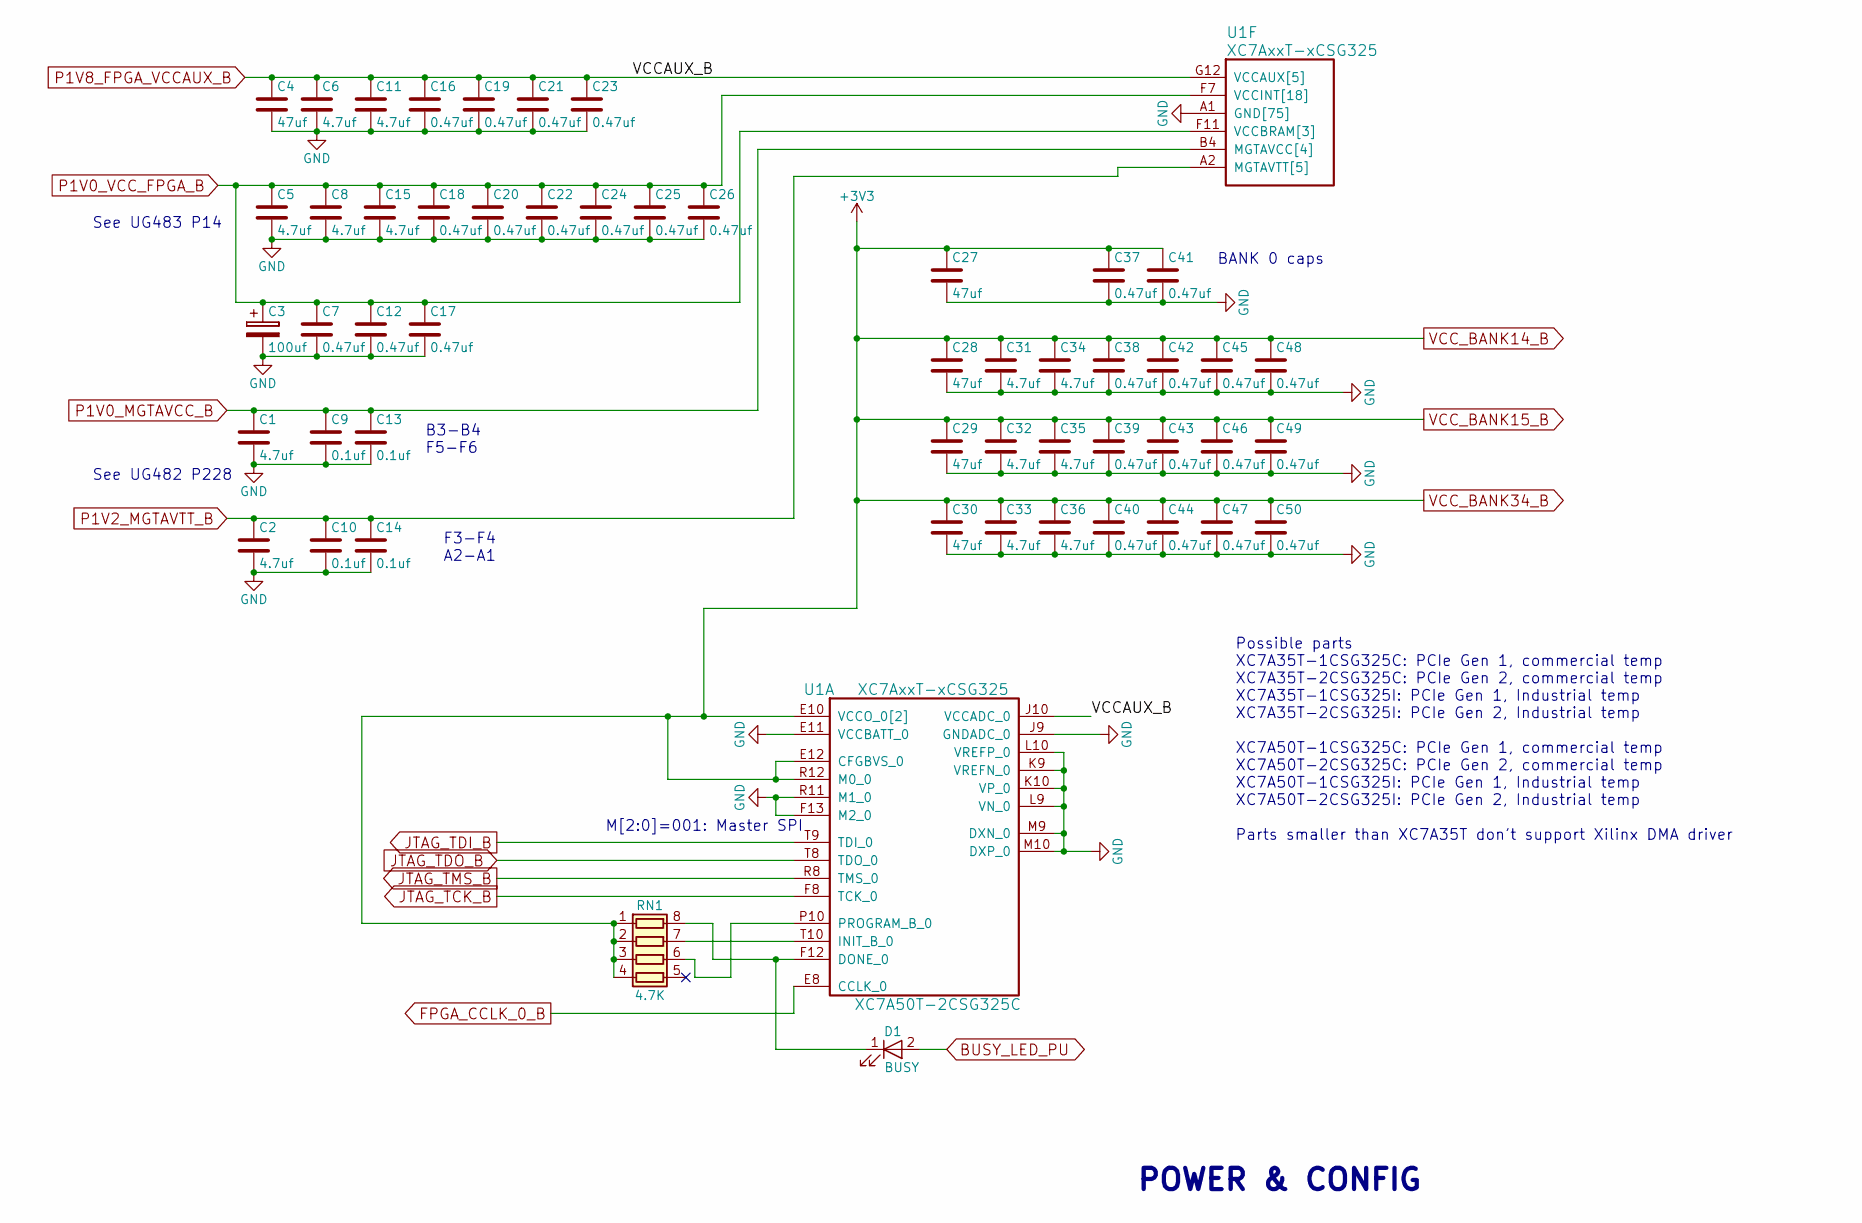
[picture p18: schematic fpga_pwr_cfg_b.sch, PicoEVB]

Parts:
C1, C2, C5, C6, C8, C11, C15, C31, C32, C33, C34, C35, C36: 4.7uf; c_0402; MPN CC0402MRX5R5BB475
C3: 100uf; C_0805; MPN F950J107MPAAQ2
C4, C27, C28, C29, C30: 47uf; C_0603; MPN GRM188R60G476ME15D
C7, C12, C16, C17, C18, C19, C20, C21, C22, C23, C24, C25, C26, C37, C38, C39, C40, C41, C42, C43, C44, C45, C46, C47, C48, C49, C50: 0.47uf; c_0201_least; MPN cc0201krx5r5bb474
C9, C10, C13, C14: 0.1uf; c_0201_least; MPN cc0201krx5r5bb104
D1: BUSY; LED_0402; MPN LNJ247W82RA
RN1: 4.7K; R_Array_Convex_4x0402; MPN 741X083472JP
U1: XC7AxxT-xCSG325

Connections:
BUSY_LED_PU: D1.2 (A); also elsewhere on the board
FPGA_CCLK_0_B: U1.E8 (CCLK_0); also elsewhere on the board
GND: C1.2, C2.2, C3.2, C4.2, C5.2, C6.2, C7.2, C8.2, C9.2, C10.2, C11.2, C12.2, C13.2, C14.2, C15.2, C16.2, C17.2, C18.2, C19.2, C20.2, C21.2, C22.2, C23.2, C24.2, C25.2, C26.2, C27.2, C28.2, C29.2, C30.2, C31.2, C32.2, C33.2, C34.2, C35.2, C36.2, C37.2, C38.2, C39.2, C40.2, C41.2, C42.2, C43.2, C44.2, C45.2, C46.2, C47.2, C48.2, C49.2, C50.2, U1.A1 (GND[75]), U1.A5 (GND[75]), U1.A7 (GND[75]), U1.A8 (GND[75]), U1.A11 (GND[75]), U1.A18 (GND[75]), U1.B3 (GND[75]), U1.B7 (GND[75]), U1.B8 (GND[75]), U1.B18 (GND[75]), U1.C2 (GND[75]), U1.C6 (GND[75]), U1.C7 (GND[75]), U1.C15 (GND[75]), U1.D3 (GND[75]), U1.D4 (GND[75]), U1.D7 (GND[75]), U1.D12 (GND[75]), U1.E2 (GND[75]), U1.E6 (GND[75]), U1.E7 (GND[75]), U1.E9 (GND[75]), U1.E11 (VCCBATT_0), U1.F4 (GND[75]), U1.F6 (GND[75]), U1.F10 (GND[75]), U1.F13 (M2_0), U1.F16 (GND[75]), U1.G1 (GND[75]), U1.G5 (GND[75]), U1.G6 (GND[75]), U1.G7 (GND[75]), U1.G9 (GND[75]), U1.G11 (GND[75]), U1.G13 (GND[75]), U1.H3 (GND[75]), U1.H4 (GND[75]), U1.H5 (GND[75]), U1.H6 (GND[75]), U1.H8 (GND[75]), U1.H10 (GND[75]), U1.H12 (GND[75]), U1.J1 (GND[75]), U1.J2 (GND[75]), U1.J3 (GND[75]), U1.J7 (GND[75]), U1.J9 (GNDADC_0), U1.J11 (GND[75]), U1.J13 (GND[75]), U1.J17 (GND[75]), U1.K4 (GND[75]), U1.K8 (GND[75]), U1.K9 (VREFN_0), U1.K10 (VP_0), U1.K12 (GND[75]), U1.K14 (GND[75]), U1.L1 (GND[75]), U1.L7 (GND[75]), U1.L9 (VN_0), U1.L10 (VREFP_0), U1.L11 (GND[75]), U1.L13 (GND[75]), U1.M8 (GND[75]), U1.M9 (DXN_0), U1.M10 (DXP_0), U1.M12 (GND[75]), U1.M18 (GND[75]), U1.N5 (GND[75]), U1.N7 (GND[75]), U1.N9 (GND[75]), U1.N11 (GND[75]), U1.N13 (GND[75]), U1.N15 (GND[75]), U1.P2 (GND[75]), U1.P8 (GND[75]), U1.P12 (GND[75]), U1.R9 (GND[75]), U1.R11 (M1_0), U1.T6 (GND[75]), U1.T16 (GND[75]), U1.U3 (GND[75]), U1.U13 (GND[75]), U1.V1 (GND[75]), U1.V10 (GND[75]), U1.V18 (GND[75]); also elsewhere on the board
JTAG_TCK_B: U1.F8 (TCK_0); also elsewhere on the board
JTAG_TDI_B: U1.T9 (TDI_0); also elsewhere on the board
JTAG_TDO_B: U1.T8 (TDO_0); also elsewhere on the board
JTAG_TMS_B: U1.R8 (TMS_0); also elsewhere on the board
unnamed: D1.1 (K), RN1.8 (R1.2), U1.F12 (DONE_0)
unnamed: RN1.6 (R3.2), U1.P10 (PROGRAM_B_0)
unnamed: RN1.7 (R2.2), U1.T10 (INIT_B_0)
P1V0_MGTAVCC_B: C1.1, C9.1, C13.1, U1.B4 (MGTAVCC[4]), U1.C5 (MGTAVCC[4]), U1.E5 (MGTAVCC[4]), U1.F5 (MGTAVCC[4]); also elsewhere on the board
P1V0_VCC_FPGA_B: C3.1, C5.1, C7.1, C8.1, C12.1, C15.1, C17.1, C18.1, C20.1, C22.1, C24.1, C25.1, C26.1, U1.F7 (VCCINT[18]), U1.F9 (VCCINT[18]), U1.F11 (VCCBRAM[3]), U1.G8 (VCCINT[18]), U1.G10 (VCCBRAM[3]), U1.H7 (VCCINT[18]), U1.H9 (VCCINT[18]), U1.H11 (VCCBRAM[3]), U1.J8 (VCCINT[18]), U1.J12 (VCCINT[18]), U1.K7 (VCCINT[18]), U1.K11 (VCCINT[18]), U1.L8 (VCCINT[18]), U1.L12 (VCCINT[18]), U1.M7 (VCCINT[18]), U1.M11 (VCCINT[18]), U1.N8 (VCCINT[18]), U1.N10 (VCCINT[18]), U1.N12 (VCCINT[18]), U1.P9 (VCCINT[18]), U1.P11 (VCCINT[18]); also elsewhere on the board
P1V2_MGTAVTT_B: C2.1, C10.1, C14.1, U1.A2 (MGTAVTT[5]), U1.C1 (MGTAVTT[5]), U1.E1 (MGTAVTT[5]), U1.F3 (MGTAVTT[5]), U1.G2 (MGTAVTT[5]); also elsewhere on the board
P1V8_FPGA_VCCAUX_B: C4.1, C6.1, C11.1, C16.1, C19.1, C21.1, C23.1, U1.G12 (VCCAUX[5]), U1.H13 (VCCAUX[5]), U1.J10 (VCCADC_0), U1.K13 (VCCAUX[5]), U1.M13 (VCCAUX[5]), U1.P13 (VCCAUX[5]); also elsewhere on the board
VCC_BANK14_B: C27.1, C28.1, C29.1, C30.1, C31.1, C32.1, C33.1, C34.1, C35.1, C36.1, C37.1, C38.1, C39.1, C40.1, C41.1, C42.1, C43.1, C44.1, C45.1, C46.1, C47.1, C48.1, C49.1, C50.1, RN1.1 (R1.1), RN1.2 (R2.1), RN1.3 (R3.1), RN1.4 (R4.1), U1.E10 (VCCO_0[2]), U1.E12 (CFGBVS_0), U1.R10 (VCCO_0[2]), U1.R12 (M0_0); also elsewhere on the board

Notes on the sheet:
See UG482 P228
See UG483 P14
M[2:0]=001: Master SPI
B3-B4 F5-F6
F3-F4 A2-A1
POWER & CONFIG
BANK 0 caps
Possible parts XC7A35T-1CSG325C: PCIe Gen 1, commercial temp XC7A35T-2CSG325C: PCIe Gen 2, commercial temp XC7A35T-1CSG325I: PCIe Gen 1, Industrial temp XC7A35T-2CSG325I: PCIe Gen 2, Industrial temp XC7A50T-1CSG325C: PCIe Gen 1, commercial temp XC7A50T-2CSG325C: PCIe Gen 2, commercial temp XC7A50T-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

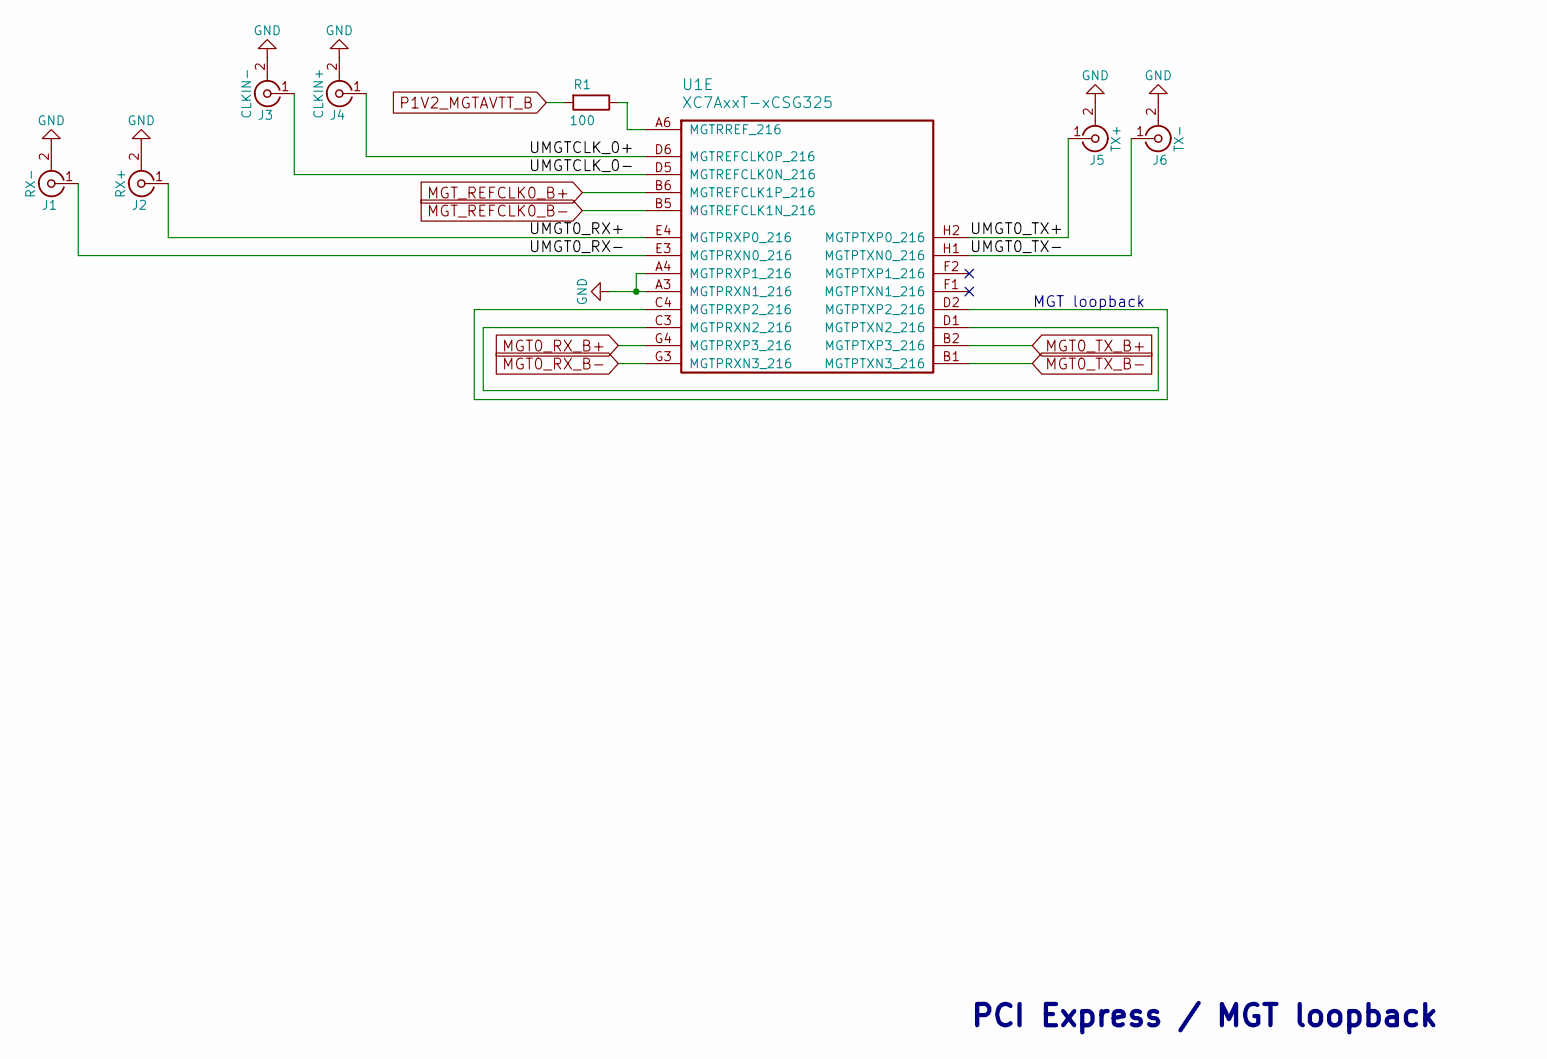
[picture p19: schematic fpga_pcie_b.sch, PicoEVB]

Parts:
J1: RX-; U.FL-COAX; MPN U.FL-R-SMT(10)
J2: RX+; U.FL-COAX; MPN U.FL-R-SMT(10)
J3: CLKIN-; U.FL-COAX; MPN U.FL-R-SMT(10)
J4: CLKIN+; U.FL-COAX; MPN U.FL-R-SMT(10)
J5: TX+; U.FL-COAX; MPN U.FL-R-SMT(10)
J6: TX-; U.FL-COAX; MPN U.FL-R-SMT(10)
R1: 100; r_0201_least; MPN RC0201FR-07100RL
U1: XC7AxxT-xCSG325

Connections:
/FPGA PCIe/UMGT0_RX+: J2.1 (In), U1.E4 (MGTPRXP0_216)
/FPGA PCIe/UMGT0_RX-: J1.1 (In), U1.E3 (MGTPRXN0_216)
/FPGA PCIe/UMGT0_TX+: J5.1 (In), U1.H2 (MGTPTXP0_216)
/FPGA PCIe/UMGT0_TX-: J6.1 (In), U1.H1 (MGTPTXN0_216)
/FPGA PCIe/UMGTCLK_0+: J4.1 (In), U1.D6 (MGTREFCLK0P_216)
/FPGA PCIe/UMGTCLK_0-: J3.1 (In), U1.D5 (MGTREFCLK0N_216)
GND: J1.2 (Ext), J2.2 (Ext), J3.2 (Ext), J4.2 (Ext), J5.2 (Ext), J6.2 (Ext), U1.A3 (MGTPRXN1_216), U1.A4 (MGTPRXP1_216); also elsewhere on the board
MGT0_RX_B+: U1.G4 (MGTPRXP3_216); also elsewhere on the board
MGT0_RX_B-: U1.G3 (MGTPRXN3_216); also elsewhere on the board
MGT0_TX_B+: U1.B2 (MGTPTXP3_216); also elsewhere on the board
MGT0_TX_B-: U1.B1 (MGTPTXN3_216); also elsewhere on the board
MGT_REFCLK0_B+: U1.B6 (MGTREFCLK1P_216); also elsewhere on the board
MGT_REFCLK0_B-: U1.B5 (MGTREFCLK1N_216); also elsewhere on the board
unnamed: R1.1, U1.A6 (MGTRREF_216)
unnamed: U1.C3 (MGTPRXN2_216), U1.D1 (MGTPTXN2_216)
unnamed: U1.C4 (MGTPRXP2_216), U1.D2 (MGTPTXP2_216)
P1V2_MGTAVTT_B: R1.2; also elsewhere on the board

Notes on the sheet:
MGT loopback
PCI Express / MGT loopback

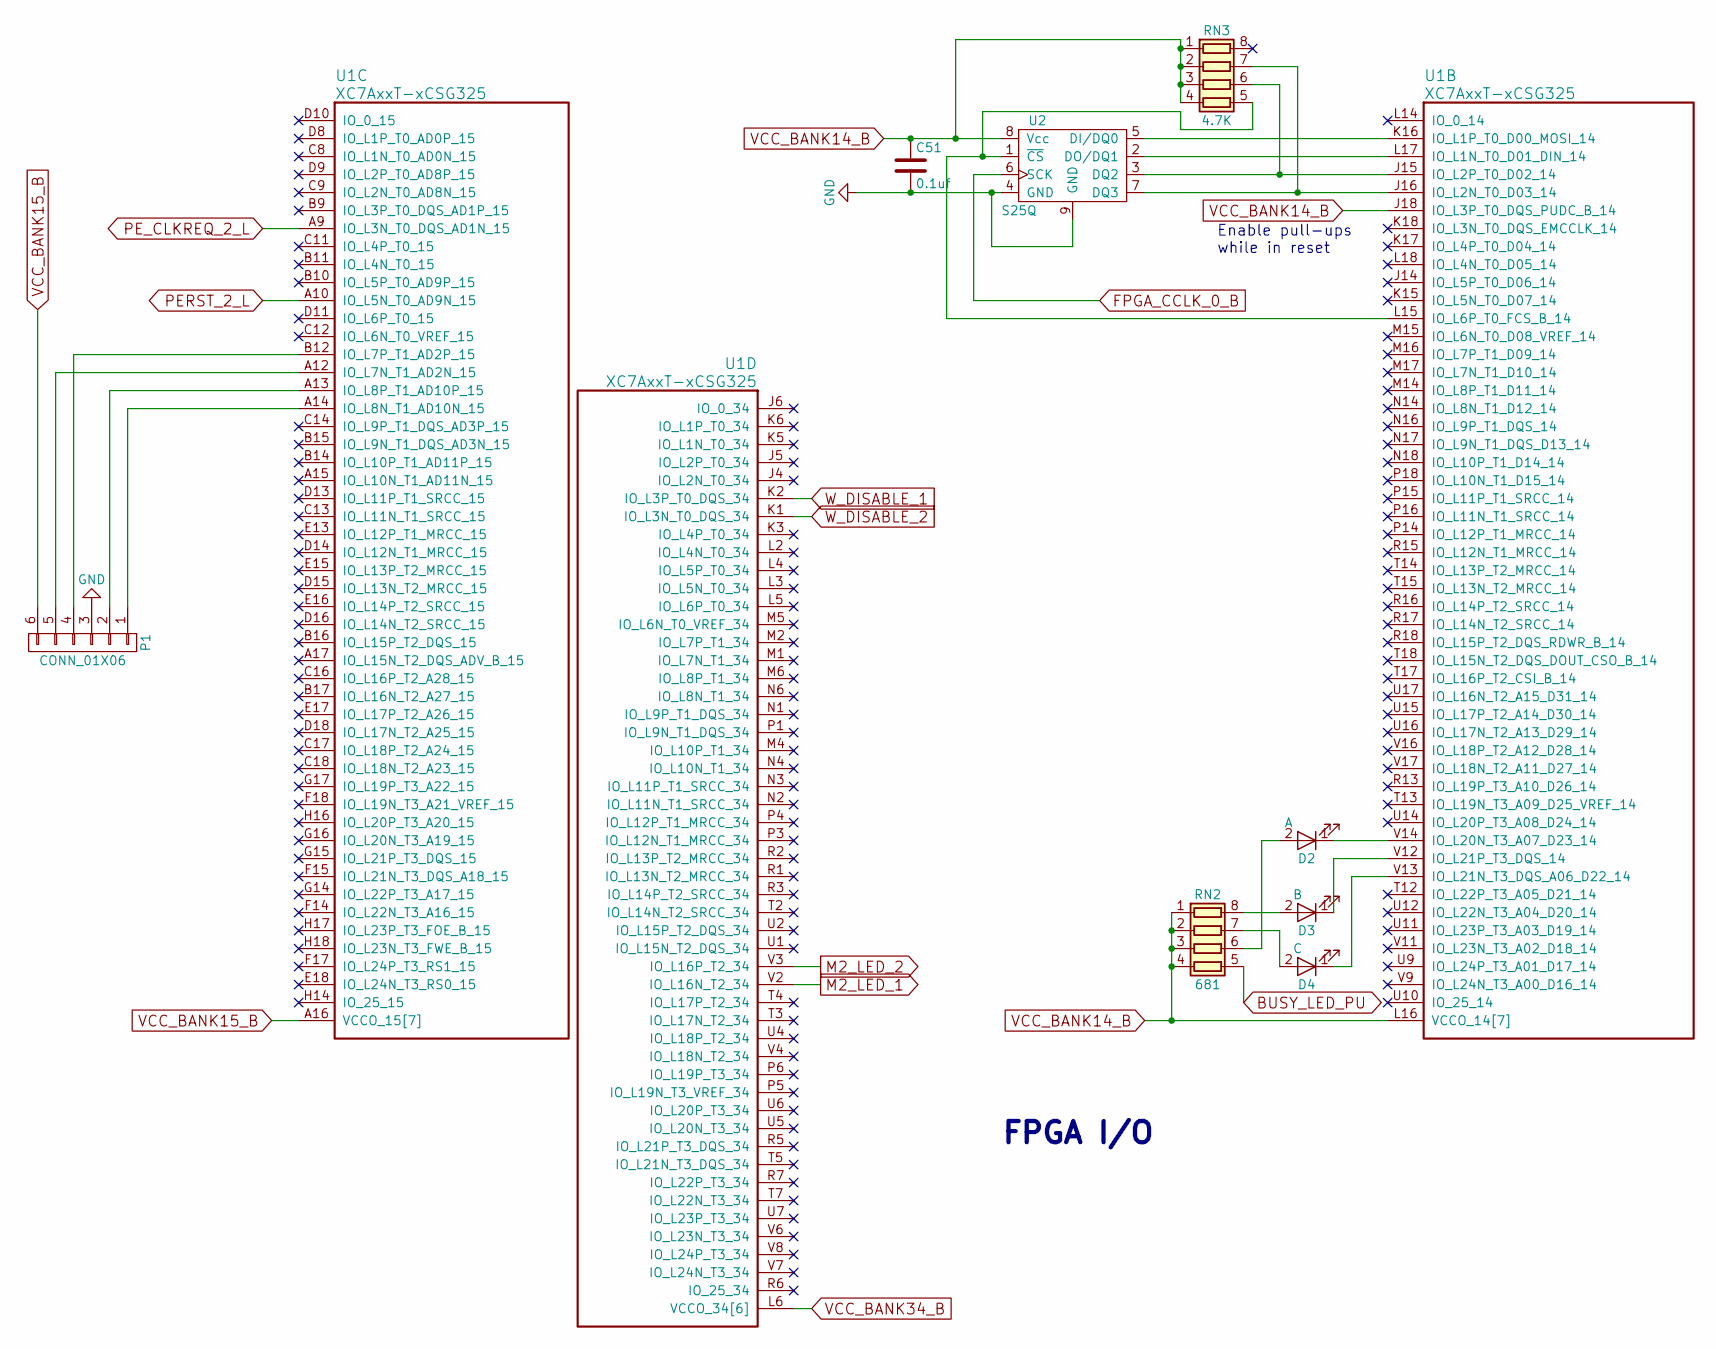
[picture p20: schematic fpga_io_b.sch, PicoEVB]

Parts:
C51: 0.1uf; c_0201_least; MPN cc0201krx5r5bb104
D2: A; LED_0402; MPN LNJ247W82RA
D3: B; LED_0402; MPN LNJ247W82RA
D4: C; LED_0402; MPN LNJ247W82RA
P1: CONN_01X06; pico-ezmate-6; MPN 78171-5006
RN2: 681; R_Array_Convex_4x0402; MPN 741X083681JP
RN3: 4.7K; R_Array_Convex_4x0402; MPN 741X083472JP
U1: XC7AxxT-xCSG325
U2: S25Q; SOIC-8_3.9x4.9mm_Pitch1.27mm; MPN S25FL032P0XNFI011

Connections:
BUSY_LED_PU: RN2.5 (R4.2); also elsewhere on the board
FPGA_CCLK_0_B: U2.6 (SCK); also elsewhere on the board
GND: C51.2, P1.3, U2.4 (GND), U2.9 (GND); also elsewhere on the board
M2_LED_1: U1.V2 (IO_L16N_T2_34); also elsewhere on the board
M2_LED_2: U1.V3 (IO_L16P_T2_34); also elsewhere on the board
unnamed: D2.1 (K), U1.V14 (IO_L20N_T3_A07_D23_14)
unnamed: D2.2 (A), RN2.6 (R3.2)
unnamed: D3.1 (K), U1.V12 (IO_L21P_T3_DQS_14)
unnamed: D3.2 (A), RN2.8 (R1.2)
unnamed: D4.1 (K), U1.V13 (IO_L21N_T3_DQS_A06_D22_14)
unnamed: D4.2 (A), RN2.7 (R2.2)
unnamed: P1.1, U1.A14 (IO_L8N_T1_AD10N_15)
unnamed: P1.2, U1.A13 (IO_L8P_T1_AD10P_15)
unnamed: P1.4, U1.B12 (IO_L7P_T1_AD2P_15)
unnamed: P1.5, U1.A12 (IO_L7N_T1_AD2N_15)
unnamed: RN3.5 (R4.2), U1.L15 (IO_L6P_T0_FCS_B_14), U2.1 (~CS)
unnamed: RN3.6 (R3.2), U1.J15 (IO_L2P_T0_D02_14), U2.3 (DQ2)
unnamed: RN3.7 (R2.2), U1.J16 (IO_L2N_T0_D03_14), U2.7 (DQ3)
unnamed: U1.K16 (IO_L1P_T0_D00_MOSI_14), U2.5 (DI/DQ0)
unnamed: U1.L17 (IO_L1N_T0_D01_DIN_14), U2.2 (DO/DQ1)
PERST_2_L: U1.A10 (IO_L5N_T0_AD9N_15); also elsewhere on the board
PE_CLKREQ_2_L: U1.A9 (IO_L3N_T0_DQS_AD1N_15); also elsewhere on the board
VCC_BANK14_B: C51.1, P1.6, RN2.1 (R1.1), RN2.2 (R2.1), RN2.3 (R3.1), RN2.4 (R4.1), RN3.1 (R1.1), RN3.2 (R2.1), RN3.3 (R3.1), RN3.4 (R4.1), U1.A16 (VCCO_15[7]), U1.B13 (VCCO_15[7]), U1.C10 (VCCO_15[7]), U1.D17 (VCCO_15[7]), U1.E14 (VCCO_15[7]), U1.G18 (VCCO_15[7]), U1.H15 (VCCO_15[7]), U1.J18 (IO_L3P_T0_DQS_PUDC_B_14), U1.L6 (VCCO_34[6]), U1.L16 (VCCO_14[7]), U1.M3 (VCCO_34[6]), U1.P7 (VCCO_34[6]), U1.P17 (VCCO_14[7]), U1.R4 (VCCO_34[6]), U1.R14 (VCCO_14[7]), U1.T1 (VCCO_34[6]), U1.T11 (VCCO_14[7]), U1.U8 (VCCO_14[7]), U1.U18 (VCCO_14[7]), U1.V5 (VCCO_34[6]), U1.V15 (VCCO_14[7]), U2.8 (Vcc); also elsewhere on the board
W_DISABLE_1: U1.K2 (IO_L3P_T0_DQS_34); also elsewhere on the board
W_DISABLE_2: U1.K1 (IO_L3N_T0_DQS_34); also elsewhere on the board

Notes on the sheet:
Enable pull-ups while in reset
FPGA I/O

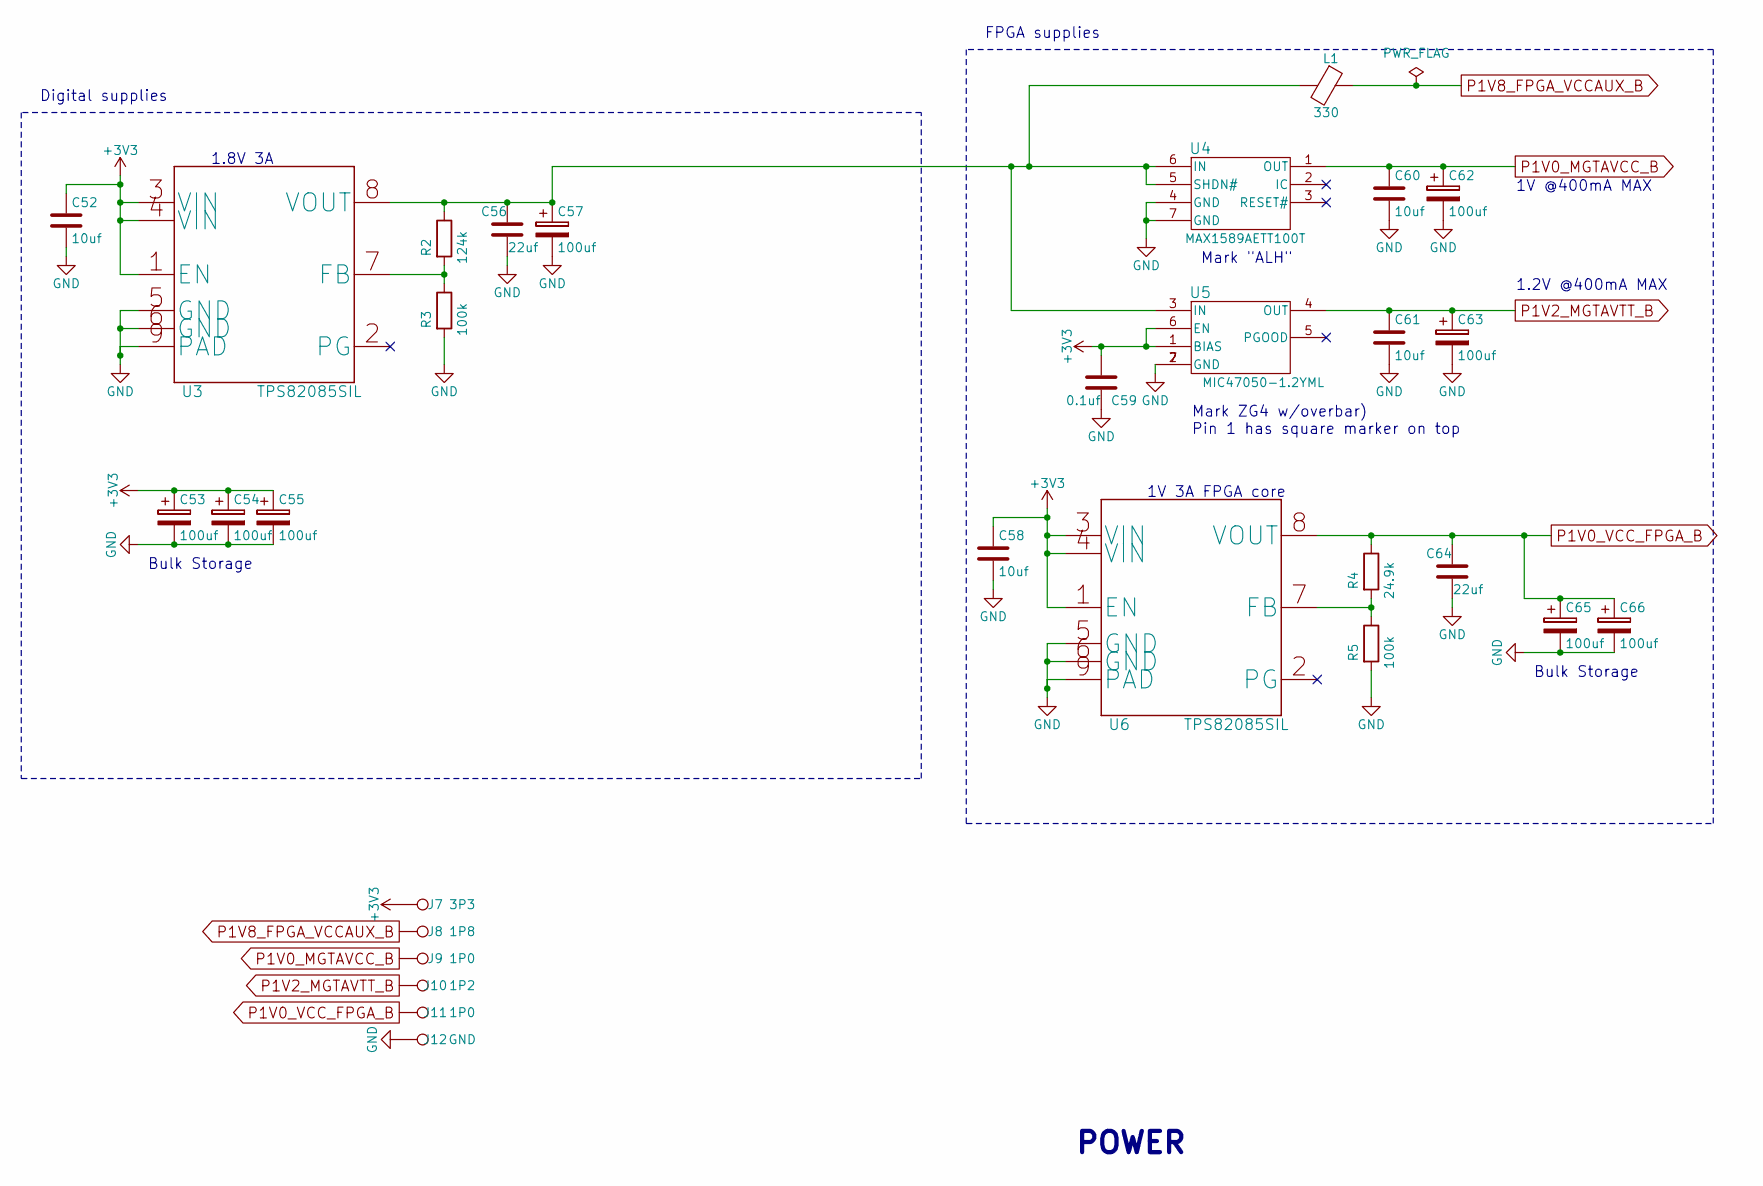
[picture p21: schematic power_b.sch, PicoEVB]

Parts:
C52, C58, C60, C61: 10uf; c_0402; MPN CC0402MRX5R5BB106
C53, C54, C55, C57, C62, C63, C65, C66: 100uf; C_0805; MPN F950J107MPAAQ2
C56, C64: 22uf; C_0603; MPN CC0603MRX5R6BB226
C59: 0.1uf; c_0201_least; MPN cc0201krx5r5bb104
J7: 3P3; SolderWirePad_single_SMD_1x1mm
J8: 1P8; SolderWirePad_single_SMD_1x1mm
J9, J11: 1P0; SolderWirePad_single_SMD_1x1mm
J10: 1P2; SolderWirePad_single_SMD_1x1mm
J12: GND; SolderWirePad_single_SMD_1x1mm
L1: 330; r_0402; MPN BKP1005EM331-T
R2: 124k; r_0201_least; MPN RC0201FR-07124KL
R3, R5: 100k; r_0201_least; MPN RC0201FR-07100KL
R4: 24.9k; r_0201_least; MPN RC0201FR-0724K9L
U3, U6: TPS82085SIL; TPS82084SILR; MPN TPS82085SILT
U4: MAX1589AETT100T; MPN MAX1589AETT100+T
U5: MIC47050-1.2YML; MIC47050-DFN-6-2MM; MPN MIC47050-1.2YML-TR

Connections:
GND: C52.2, C53.2, C54.2, C55.2, C56.2, C57.2, C58.2, C59.2, C60.2, C61.2, C62.2, C63.2, C64.2, C65.2, C66.2, J12.1, R3.2, R5.2, U3.5 (GND), U3.6 (GND), U3.9 (PAD), U4.4 (GND), U4.7 (GND), U5.2 (GND), U5.7 (GND), U6.5 (GND), U6.6 (GND), U6.9 (PAD); also elsewhere on the board
unnamed: C56.1, C57.1, L1.2, R2.1, U3.8 (VOUT), U4.5 (SHDN#), U4.6 (IN), U5.3 (IN)
unnamed: R2.2, R3.1, U3.7 (FB)
unnamed: R4.2, R5.1, U6.7 (FB)
P1V0_MGTAVCC_B: C60.1, C62.1, J9.1, U4.1 (OUT); also elsewhere on the board
P1V0_VCC_FPGA_B: C64.1, C65.1, C66.1, J11.1, R4.1, U6.8 (VOUT); also elsewhere on the board
P1V2_MGTAVTT_B: C61.1, C63.1, J10.1, U5.4 (OUT); also elsewhere on the board
P1V8_FPGA_VCCAUX_B: J8.1, L1.1; also elsewhere on the board
VCC_BANK14_B: C52.1, C53.1, C54.1, C55.1, C58.1, C59.1, J7.1, U3.1 (EN), U3.3 (VIN), U3.4 (VIN), U5.1 (BIAS), U5.6 (EN), U6.1 (EN), U6.3 (VIN), U6.4 (VIN); also elsewhere on the board

Notes on the sheet:
1.8V 3A
1V 3A FPGA core
1V @400mA MAX
1.2V @400mA MAX
Digital supplies
FPGA supplies
Bulk Storage
Mark "ALH"
Mark ZG4 w/overbar) Pin 1 has square marker on top
POWER

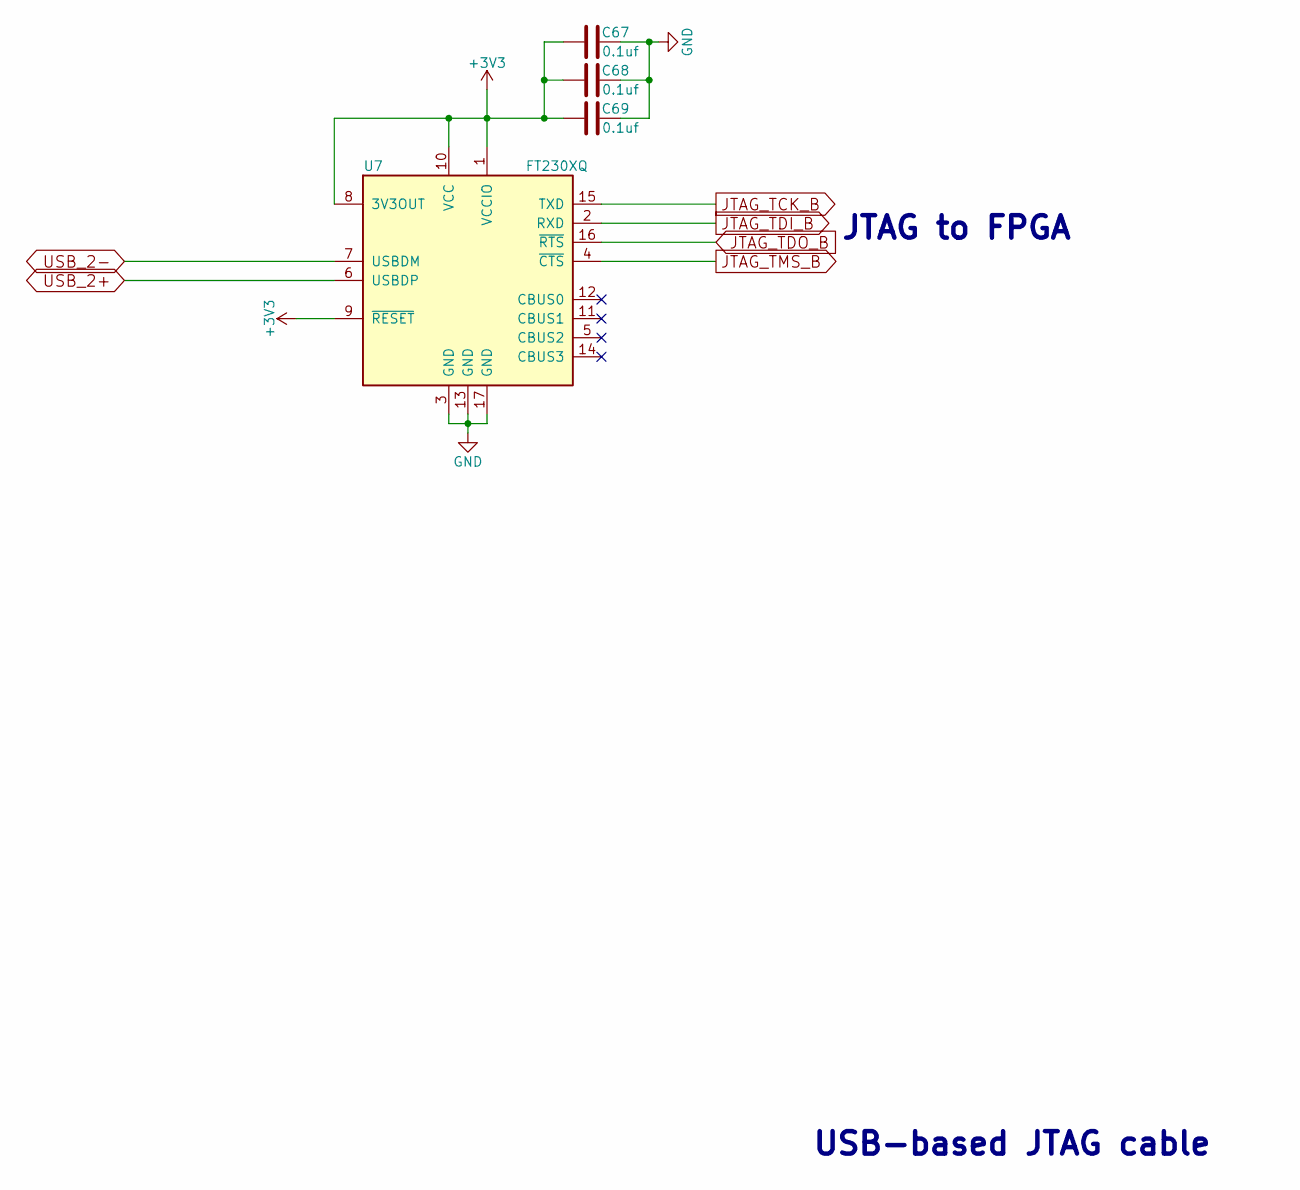
[picture p22: schematic USB_IO_b.sch, PicoEVB]

Parts:
C67, C68, C69: 0.1uf; c_0201_least; MPN cc0201krx5r5bb104
U7: FT230XQ; QFN-16-1EP_4x4mm_Pitch0.65mm; MPN FT230XQ

Connections:
GND: C67.2, C68.2, C69.2, U7.3 (GND), U7.13 (GND), U7.17 (GND); also elsewhere on the board
JTAG_TCK_B: U7.15 (TXD); also elsewhere on the board
JTAG_TDI_B: U7.2 (RXD); also elsewhere on the board
JTAG_TDO_B: U7.16 (~RTS); also elsewhere on the board
JTAG_TMS_B: U7.4 (~CTS); also elsewhere on the board
USB_2+: U7.6 (USBDP); also elsewhere on the board
USB_2-: U7.7 (USBDM); also elsewhere on the board
VCC_BANK14_B: C67.1, C68.1, C69.1, U7.1 (VCCIO), U7.8 (3V3OUT), U7.9 (~RESET), U7.10 (VCC); also elsewhere on the board

Notes on the sheet:
USB-based JTAG cable
JTAG to FPGA

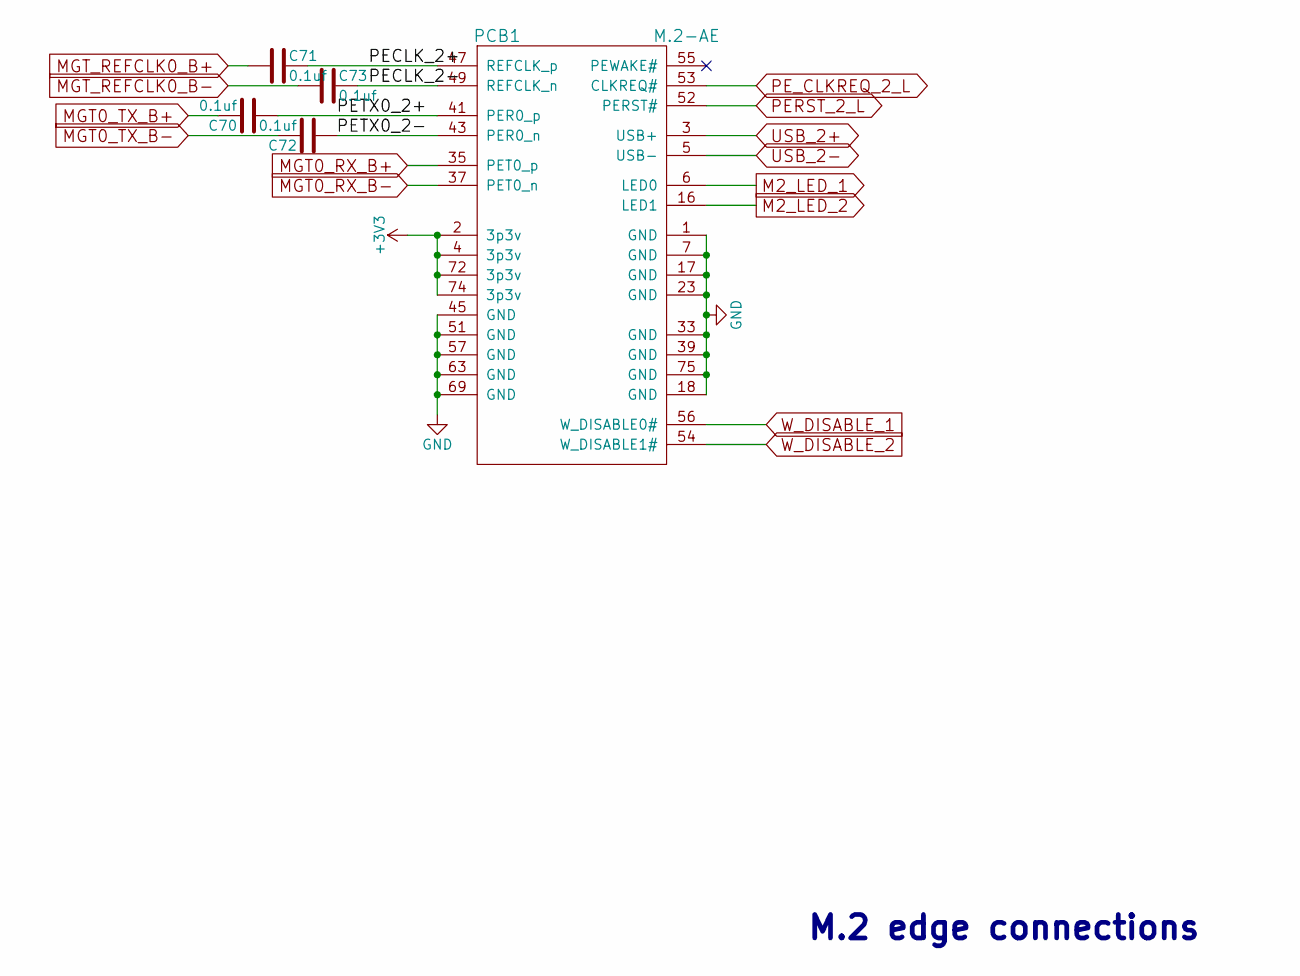
[picture p23: schematic M2_edge_b.sch, PicoEVB]

Parts:
C70, C71, C72, C73: 0.1uf; c_0201_least; MPN cc0201krx5r5bb104
PCB1: M.2-AE; M.2-AE-22x42; MPN xxx

Connections:
/M2 edge/PECLK_2+: C71.1, PCB1.47 (REFCLK_p)
/M2 edge/PECLK_2-: C73.1, PCB1.49 (REFCLK_n)
/M2 edge/PETX0_2+: C70.2, PCB1.41 (PER0_p)
/M2 edge/PETX0_2-: C72.2, PCB1.43 (PER0_n)
GND: PCB1.1 (GND), PCB1.7 (GND), PCB1.17 (GND), PCB1.18 (GND), PCB1.23 (GND), PCB1.33 (GND), PCB1.39 (GND), PCB1.45 (GND), PCB1.51 (GND), PCB1.57 (GND), PCB1.63 (GND), PCB1.69 (GND), PCB1.75 (GND); also elsewhere on the board
M2_LED_1: PCB1.6 (LED0); also elsewhere on the board
M2_LED_2: PCB1.16 (LED1); also elsewhere on the board
MGT0_RX_B+: PCB1.35 (PET0_p); also elsewhere on the board
MGT0_RX_B-: PCB1.37 (PET0_n); also elsewhere on the board
MGT0_TX_B+: C70.1; also elsewhere on the board
MGT0_TX_B-: C72.1; also elsewhere on the board
MGT_REFCLK0_B+: C71.2; also elsewhere on the board
MGT_REFCLK0_B-: C73.2; also elsewhere on the board
PERST_2_L: PCB1.52 (PERST#); also elsewhere on the board
PE_CLKREQ_2_L: PCB1.53 (CLKREQ#); also elsewhere on the board
USB_2+: PCB1.3 (USB+); also elsewhere on the board
USB_2-: PCB1.5 (USB-); also elsewhere on the board
VCC_BANK14_B: PCB1.2 (3p3v), PCB1.4 (3p3v), PCB1.72 (3p3v), PCB1.74 (3p3v); also elsewhere on the board
W_DISABLE_1: PCB1.56 (W_DISABLE0#); also elsewhere on the board
W_DISABLE_2: PCB1.54 (W_DISABLE1#); also elsewhere on the board

Notes on the sheet:
M.2 edge connections

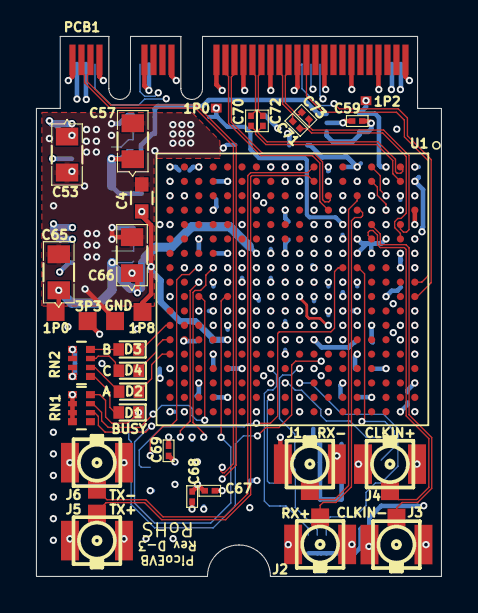
[picture p24: board PicoEVB.kicad_pcb from above]

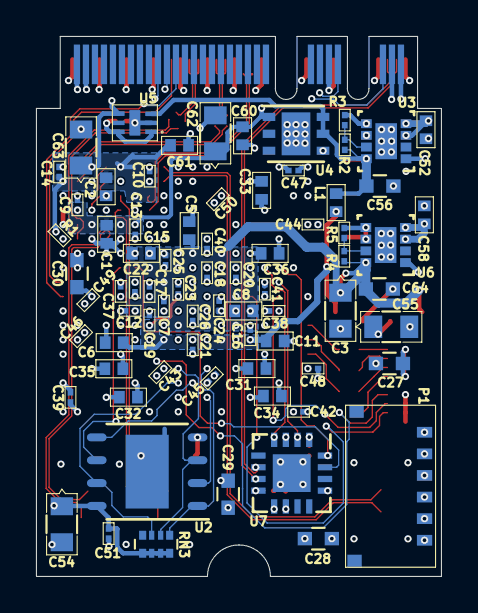
[picture p25: board PicoEVB.kicad_pcb from below]

Board: 4 copper layers, 22.5 x 30.0 mm, 107 parts (74 on the bottom side), 60 nets.
