RHSResearchLLC/PicoEVB/DMADriver/driver/include/perfmon_parameters.h

/*
 * Performance Monitoring Internal Parameters
 * Date:   January 9, 2015
 * Author: Paul Schumacher
 *
 * NOTE: partially taken from file xaxipmon_hw.h in v5.0 of APM driver
 */

#ifndef _PERFMON_PARAMETERS_H
#define _PERFMON_PARAMETERS_H

/************************ AXI Stream FIFOs ************************************/

/* Address offsets in core */
#define AXI_FIFO_RDFR                           0x18
#define AXI_FIFO_RDFD                           0x20
#define AXI_FIFO_RDFD_AXI_FULL                  0x1000
#define AXI_FIFO_RLR                            0x24
#define AXI_FIFO_SRR                            0x28
#define AXI_FIFO_RESET_VALUE                    0xA5

/************************ APM Constant Definitions ****************************/

/* Register offsets of AXIMONITOR in the Device Config */

#define XAPM_GCC_HIGH_OFFSET	0x0000	/**< Global Clock Counter 32 to 63 bits  */
#define XAPM_GCC_LOW_OFFSET		0x0004	/**< Global Clock Counter Lower 0-31 bits  */
#define XAPM_SI_HIGH_OFFSET		0x0020	/**< Sample Interval MSB */
#define XAPM_SI_LOW_OFFSET		0x0024	/**< Sample Interval LSB */
#define XAPM_SICR_OFFSET		0x0028	/**< Sample Interval Control Register */
#define XAPM_SR_OFFSET			0x002C	/**< Sample Register */
#define XAPM_GIE_OFFSET			0x0030	/**< Global Interrupt Enable Register */
#define XAPM_IE_OFFSET			0x0034	/**< Interrupt Enable Register */
#define XAPM_IS_OFFSET			0x0038	/**< Interrupt Status Register */

#define XAPM_MSR0_OFFSET		0x0044	/**< Metric Selector 0 Register */
#define XAPM_MSR1_OFFSET		0x0048	/**< Metric Selector 1 Register */
#define XAPM_MSR2_OFFSET		0x004C	/**< Metric Selector 2 Register */

#define XAPM_MC0_OFFSET			0x0100	/**< Metric Counter 0 Register */
#define XAPM_INC0_OFFSET		0x0104	/**< Incrementer 0 Register */
#define XAPM_RANGE0_OFFSET		0x0108	/**< Range 0 Register */
#define XAPM_MC0LOGEN_OFFSET	0x010C	/**< Metric Counter 0 Log Enable Register */
#define XAPM_MC1_OFFSET			0x0110	/**< Metric Counter 1 Register */
#define XAPM_INC1_OFFSET		0x0114	/**< Incrementer 1 Register */
#define XAPM_RANGE1_OFFSET		0x0118	/**< Range 1 Register */
#define XAPM_MC1LOGEN_OFFSET	0x011C	/**< Metric Counter 1 Log Enable Register */
#define XAPM_MC2_OFFSET			0x0120	/**< Metric Counter 2 Register */
#define XAPM_INC2_OFFSET		0x0124	/**< Incrementer 2 Register */
#define XAPM_RANGE2_OFFSET		0x0128	/**< Range 2 Register */
#define XAPM_MC2LOGEN_OFFSET	0x012C	/**< Metric Counter 2 Log Enable Register */
#define XAPM_MC3_OFFSET			0x0130	/**< Metric Counter 3 Register */
#define XAPM_INC3_OFFSET		0x0134	/**< Incrementer 3 Register */
#define XAPM_RANGE3_OFFSET		0x0138	/**< Range 3 Register */
#define XAPM_MC3LOGEN_OFFSET	0x013C	/**< Metric Counter 3 Log Enable Register */
#define XAPM_MC4_OFFSET			0x0140	/**< Metric Counter 4 Register */
#define XAPM_INC4_OFFSET		0x0144	/**< Incrementer 4 Register */
#define XAPM_RANGE4_OFFSET		0x0148	/**< Range 4 Register */
#define XAPM_MC4LOGEN_OFFSET	0x014C	/**< Metric Counter 4 Log Enable Register */
#define XAPM_MC5_OFFSET			0x0150	/**< Metric Counter 5 Register */
#define XAPM_INC5_OFFSET		0x0154	/**< Incrementer 5 Register */
#define XAPM_RANGE5_OFFSET		0x0158	/**< Range 5 Register */
#define XAPM_MC5LOGEN_OFFSET	0x015C	/**< Metric Counter 5 Log Enable Register */
#define XAPM_MC6_OFFSET			0x0160	/**< Metric Counter 6 Register */
#define XAPM_INC6_OFFSET		0x0164	/**< Incrementer 6 Register */
#define XAPM_RANGE6_OFFSET		0x0168	/**< Range 6 Register */
#define XAPM_MC6LOGEN_OFFSET	0x016C	/**< Metric Counter 6 Log Enable Register */
#define XAPM_MC7_OFFSET			0x0170	/**< Metric Counter 7 Register */
#define XAPM_INC7_OFFSET		0x0174	/**< Incrementer 7 Register */
#define XAPM_RANGE7_OFFSET		0x0178	/**< Range 7 Register */
#define XAPM_MC7LOGEN_OFFSET	0x017C	/**< Metric Counter 7 Log Enable Register */
#define XAPM_MC8_OFFSET			0x0180	/**< Metric Counter 8 Register */
#define XAPM_INC8_OFFSET		0x0184	/**< Incrementer 8 Register */
#define XAPM_RANGE8_OFFSET		0x0188	/**< Range 8 Register */
#define XAPM_MC8LOGEN_OFFSET	0x018C	/**< Metric Counter 8 Log Enable Register */
#define XAPM_MC9_OFFSET			0x0190	/**< Metric Counter 9 Register */
#define XAPM_INC9_OFFSET		0x0194	/**< Incrementer 9 Register */
#define XAPM_RANGE9_OFFSET		0x0198	/**< Range 9 Register */
#define XAPM_MC9LOGEN_OFFSET	0x019C	/**< Metric Counter 9 Log Enable Register */

#define XAPM_SMC0_OFFSET		0x0200	/**< Sampled Metric Counter 0 Register */
#define XAPM_SINC0_OFFSET		0x0204	/**< Sampled Incrementer 0 Register */
#define XAPM_SMC1_OFFSET		0x0210	/**< Sampled Metric Counter 1 Register */
#define XAPM_SINC1_OFFSET		0x0214	/**< Sampled Incrementer 1 Register */
#define XAPM_SMC2_OFFSET		0x0220	/**< Sampled Metric Counter 2 Register */
#define XAPM_SINC2_OFFSET		0x0224	/**< Sampled Incrementer 2 Register */
#define XAPM_SMC3_OFFSET		0x0230	/**< Sampled Metric Counter 3 Register */
#define XAPM_SINC3_OFFSET		0x0234	/**< Sampled Incrementer 3 Register */
#define XAPM_SMC4_OFFSET		0x0240	/**< Sampled Metric Counter 4 Register */
#define XAPM_SINC4_OFFSET		0x0244	/**< Sampled Incrementer 4 Register */
#define XAPM_SMC5_OFFSET		0x0250	/**< Sampled Metric Counter 5 Register */
#define XAPM_SINC5_OFFSET		0x0254	/**< Sampled Incrementer 5 Register */
#define XAPM_SMC6_OFFSET		0x0260	/**< Sampled Metric Counter 6 Register */
#define XAPM_SINC6_OFFSET		0x0264	/**< Sampled Incrementer 6 Register */
#define XAPM_SMC7_OFFSET		0x0270	/**< Sampled Metric Counter 7 Register */
#define XAPM_SINC7_OFFSET		0x0274	/**< Sampled Incrementer 7 Register */
#define XAPM_SMC8_OFFSET		0x0280	/**< Sampled Metric Counter 8 Register */
#define XAPM_SINC8_OFFSET		0x0284	/**< Sampled Incrementer 8 Register */
#define XAPM_SMC9_OFFSET		0x0290	/**< Sampled Metric Counter 9 Register */
#define XAPM_SINC9_OFFSET		0x0294	/**< Sampled Incrementer 9 Register */

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
#define XAPM_SMC31_OFFSET		0x0870	/**< Sampled Metric Counter	31 Register */
#define XAPM_SMC32_OFFSET		0x0880	/**< Sampled Metric Counter	32 Register */
#define XAPM_SMC33_OFFSET		0x0890	/**< Sampled Metric Counter	33 Register */
#define XAPM_SMC34_OFFSET		0x08A0	/**< Sampled Metric Counter	34 Register */
#define XAPM_SMC35_OFFSET		0x08B0	/**< Sampled Metric Counter 35 Register */
#define XAPM_SMC36_OFFSET		0x0A00	/**< Sampled Metric Counter	36 Register */
#define XAPM_SMC37_OFFSET		0x0A10	/**< Sampled Metric Counter	37 Register */
#define XAPM_SMC38_OFFSET		0x0A20	/**< Sampled Metric Counter	38 Register */
#define XAPM_SMC39_OFFSET		0x0A30	/**< Sampled Metric Counter	39 Register */
#define XAPM_SMC40_OFFSET		0x0A40	/**< Sampled Metric Counter	40 Register */
#define XAPM_SMC41_OFFSET		0x0A50	/**< Sampled Metric Counter	41 Register */
#define XAPM_SMC42_OFFSET		0x0A60	/**< Sampled Metric Counter	42 Register */
#define XAPM_SMC43_OFFSET		0x0A70	/**< Sampled Metric Counter	43 Register */
#define XAPM_SMC44_OFFSET		0x0A80	/**< Sampled Metric Counter 44 Register */
#define XAPM_SMC45_OFFSET		0x0A90	/**< Sampled Metric Counter	45 Register */
#define XAPM_SMC46_OFFSET		0x0AA0	/**< Sampled Metric Counter	46 Register */
#define XAPM_SMC47_OFFSET		0x0AB0	/**< Sampled Metric Counter	47 Register */
/* Sampled metric counters 48-63: In Profile mode, this are min/max latency registers */
#define XAPM_SMC48_OFFSET  		0x0254  /**< Sampled Metric Counter	48 Register */
#define XAPM_SMC49_OFFSET   	0x0258  /**< Sampled Metric Counter	49 Register */
#define XAPM_SMC50_OFFSET  		0x02B4  /**< Sampled Metric Counter	50 Register */
#define XAPM_SMC51_OFFSET   	0x02B8  /**< Sampled Metric Counter	51 Register */
#define XAPM_SMC52_OFFSET  		0x0654  /**< Sampled Metric Counter	52 Register */
#define XAPM_SMC53_OFFSET   	0x0658  /**< Sampled Metric Counter	53 Register */
#define XAPM_SMC54_OFFSET  		0x06B4  /**< Sampled Metric Counter	54 Register */
#define XAPM_SMC55_OFFSET   	0x06B8  /**< Sampled Metric Counter	55 Register */
#define XAPM_SMC56_OFFSET  		0x0854  /**< Sampled Metric Counter	56 Register */
#define XAPM_SMC57_OFFSET   	0x0858  /**< Sampled Metric Counter	57 Register */
#define XAPM_SMC58_OFFSET  		0x08B4  /**< Sampled Metric Counter	58 Register */
#define XAPM_SMC59_OFFSET   	0x08B8  /**< Sampled Metric Counter	59 Register */
#define XAPM_SMC60_OFFSET  		0x0A54  /**< Sampled Metric Counter	60 Register */
#define XAPM_SMC61_OFFSET   	0x0A58  /**< Sampled Metric Counter	61 Register */
#define XAPM_SMC62_OFFSET  		0x0AB4  /**< Sampled Metric Counter	62 Register */
#define XAPM_SMC63_OFFSET   	0x0AB8  /**< Sampled Metric Counter	63 Register */

#define XAPM_CTL_OFFSET		 	0x0300	/**< Control Register */
#define XAPM_ID_OFFSET			0x0304	/**< Latency ID Register */
#define XAPM_IDMASK_OFFSET		0x0308	/**< ID Mask Register */
#define XAPM_FEC_OFFSET			0x0400	/**< Flag Enable Control Register */
#define XAPM_SWD_OFFSET			0x0404	/**< Software-written Data Register */

/* AXI Monitor Sample Interval Control Register mask(s) */

#define XAPM_SICR_MCNTR_RST_MASK	0x00000100 /**< Enable the Metric Counter Reset */
#define XAPM_SICR_LOAD_MASK			0x00000002 /**< Load the Sample Interval Register Value into the counter */
#define XAPM_SICR_ENABLE_MASK		0x00000001 /**< Enable the downcounter */

/* Interrupt Status/Enable Register Bit Definitions and Masks */

#define XAPM_IXR_MC9_OVERFLOW_MASK	0x00001000	/**< Metric Counter 9 Overflow> */
#define XAPM_IXR_MC8_OVERFLOW_MASK	0x00000800	/**< Metric Counter 8 Overflow> */
#define XAPM_IXR_MC7_OVERFLOW_MASK  0x00000400	/**< Metric Counter 7 Overflow> */
#define XAPM_IXR_MC6_OVERFLOW_MASK  0x00000200	/**< Metric Counter 6 Overflow> */
#define XAPM_IXR_MC5_OVERFLOW_MASK  0x00000100	/**< Metric Counter 5 Overflow> */
#define XAPM_IXR_MC4_OVERFLOW_MASK  0x00000080	/**< Metric Counter 4 Overflow> */
#define XAPM_IXR_MC3_OVERFLOW_MASK  0x00000040	/**< Metric Counter 3 Overflow> */
#define XAPM_IXR_MC2_OVERFLOW_MASK  0x00000020	/**< Metric Counter 2 Overflow> */
#define XAPM_IXR_MC1_OVERFLOW_MASK  0x00000010	/**< Metric Counter 1 Overflow> */
#define XAPM_IXR_MC0_OVERFLOW_MASK  0x00000008	/**< Metric Counter 0 Overflow> */
#define XAPM_IXR_FIFO_FULL_MASK   	0x00000004	/**< Event Log FIFO full> */
#define XAPM_IXR_SIC_OVERFLOW_MASK  0x00000002	/**< Sample Interval Counter Overflow> */
#define XAPM_IXR_GCC_OVERFLOW_MASK	0x00000001	/**< Global Clock Counter Overflow> */
#define XAPM_IXR_ALL_MASK		(XAPM_IXR_SIC_OVERFLOW_MASK | \
					XAPM_IXR_GCC_OVERFLOW_MASK |  \
					XAPM_IXR_FIFO_FULL_MASK | \
					XAPM_IXR_MC0_OVERFLOW_MASK | \
					XAPM_IXR_MC1_OVERFLOW_MASK | \
					XAPM_IXR_MC2_OVERFLOW_MASK | \
					XAPM_IXR_MC3_OVERFLOW_MASK | \
					XAPM_IXR_MC4_OVERFLOW_MASK | \
					XAPM_IXR_MC5_OVERFLOW_MASK | \
					XAPM_IXR_MC6_OVERFLOW_MASK | \
					XAPM_IXR_MC7_OVERFLOW_MASK | \
					XAPM_IXR_MC8_OVERFLOW_MASK | \
					XAPM_IXR_MC9_OVERFLOW_MASK)

/* AXI Monitor Control Register mask(s) */

#define XAPM_CR_FIFO_RESET_MASK			0x02000000 /**< FIFO Reset */
#define XAPM_CR_GCC_RESET_MASK			0x00020000 /**< Global Clk Counter Reset */
#define XAPM_CR_GCC_ENABLE_MASK			0x00010000 /**< Global Clk Counter Enable */
#define XAPM_CR_EVTLOG_EXTTRIGGER_MASK  0x00000200 /**< Enable External trigger to start event Log */
#define XAPM_CR_EVENTLOG_ENABLE_MASK  	0x00000100 /**< Event Log Enable */
#define XAPM_CR_RDLATENCY_END_MASK  	0x00000080 /**< Write Latency End point */
#define XAPM_CR_RDLATENCY_START_MASK  	0x00000040 /**< Read Latency Start point */
#define XAPM_CR_WRLATENCY_END_MASK  	0x00000020 /**< Write Latency End point */
#define XAPM_CR_WRLATENCY_START_MASK  	0x00000010 /**< Write Latency Start point */
#define XAPM_CR_IDFILTER_ENABLE_MASK  	0x00000008 /**< ID Filter Enable */
#define XAPM_CR_MCNTR_EXTTRIGGER_MASK  	0x00000004 /**< Enable External trigger to start Metric Counters  */
#define XAPM_CR_MCNTR_RESET_MASK   		0x00000002 /**< Metrics Counter Reset */
#define XAPM_CR_MCNTR_ENABLE_MASK  		0x00000001 /**< Metrics Counter Enable */

/* AXI Monitor ID Register mask(s) */

#define XAPM_ID_RID_MASK				0xFFFF0000 /**< Read ID */
#define XAPM_ID_WID_MASK				0x0000FFFF /**< Write ID */

/* AXI Monitor ID Mask Register mask(s) */

#define XAPM_MASKID_RID_MASK			0xFFFF0000 /**< Read ID Mask */
#define XAPM_MASKID_WID_MASK			0x0000FFFF /**< Write ID Mask*/

/* AXI Monitor Min/Max Register masks and shifts */

#define XAPM_MAX_LATENCY_MASK			0xFFFF0000 /**< Max Latency Mask */
#define XAPM_MIN_LATENCY_MASK			0x0000FFFF /**< Min Latency Mask */
#define XAPM_MAX_LATENCY_SHIFT			16         /**< Max Latency Shift */
#define XAPM_MIN_LATENCY_SHIFT			0          /**< Min Latency Shift */

#endif
