RHSResearchLLC/PicoEVB/Sample-Projects/Project-0/FPGA/xilinx_xdma_pcie_x0y0.xdc

##-----------------------------------------------------------------------------
##
## (c) Copyright 2012-2012 Xilinx, Inc. All rights reserved.
##
## This file contains confidential and proprietary information
## of Xilinx, Inc. and is protected under U.S. and
## international copyright and other intellectual property
## laws.
##
## DISCLAIMER
## This disclaimer is not a license and does not grant any
## rights to the materials distributed herewith. Except as
## otherwise provided in a valid license issued to you by
## Xilinx, and to the maximum extent permitted by applicable
## law: (1) THESE MATERIALS ARE MADE AVAILABLE "AS IS" AND
## WITH ALL FAULTS, AND XILINX HEREBY DISCLAIMS ALL WARRANTIES
## AND CONDITIONS, EXPRESS, IMPLIED, OR STATUTORY, INCLUDING
## BUT NOT LIMITED TO WARRANTIES OF MERCHANTABILITY, NON-
## INFRINGEMENT, OR FITNESS FOR ANY PARTICULAR PURPOSE; and
## (2) Xilinx shall not be liable (whether in contract or tort,
## including negligence, or under any other theory of
## liability) for any loss or damage of any kind or nature
## related to, arising under or in connection with these
## materials, including for any direct, or any indirect,
## special, incidental, or consequential loss or damage
## (including loss of data, profits, goodwill, or any type of
## loss or damage suffered as a result of any action brought
## by a third party) even if such damage or loss was
## reasonably foreseeable or Xilinx had been advised of the
## possibility of the same.
##
## CRITICAL APPLICATIONS
## Xilinx products are not designed or intended to be fail-
## safe, or for use in any application requiring fail-safe
## performance, such as life-support or safety devices or
## systems, Class III medical devices, nuclear facilities,
## applications related to the deployment of airbags, or any
## other applications that could lead to death, personal
## injury, or severe property or environmental damage
## (individually and collectively, "Critical
## Applications"). Customer assumes the sole risk and
## liability of any use of Xilinx products in Critical
## Applications, subject only to applicable laws and
## regulations governing limitations on product liability.
##
## THIS COPYRIGHT NOTICE AND DISCLAIMER MUST BE RETAINED AS
## PART OF THIS FILE AT ALL TIMES.
##
##-----------------------------------------------------------------------------
##
## Project    : The Xilinx PCI Express DMA
## File       : xilinx_xdma_pcie_x0y0.xdc
## Version    : $IpVersion
##-----------------------------------------------------------------------------
###############################################################################
# User Configuration
# Link Width   - x1
# Link Speed   - gen2
# Family       - artix7
# Part         - xc7a50t
# Package      - csg325
# Speed grade  - -2
# PCIe Block   - X0Y0
###############################################################################

#########################################################################################################################
# PCIE Core Constraints
#########################################################################################################################

###############################################################################
# Pinout and Related I/O Constraints
###############################################################################
# SYS reset (input) signal.  The sys_reset_n signal is generated
# by the PCI Express interface (PERST#).
set_property PACKAGE_PIN A10 [get_ports sys_rst_n]
set_property IOSTANDARD LVCMOS33 [get_ports sys_rst_n]
set_property PULLDOWN true [get_ports sys_rst_n]

# SYS clock 100 MHz (input) signal. The sys_clk_p and sys_clk_n
# signals are the PCI Express reference clock. 
set_property PACKAGE_PIN B6 [get_ports sys_clk_p]

# PCIe x1 link
set_property PACKAGE_PIN G4 [get_ports pcie_mgt_rxp]
set_property PACKAGE_PIN G3 [get_ports pcie_mgt_rxn]
set_property PACKAGE_PIN B2 [get_ports pcie_mgt_txp]
set_property PACKAGE_PIN B1 [get_ports pcie_mgt_txn]

# MGT Loopback
#set_property PACKAGE_PIN C4 [get_ports loop_mgt_rxp]
#set_property PACKAGE_PIN C3 [get_ports loop_mgt_rxn]
#set_property PACKAGE_PIN D2 [get_ports loop_mgt_txp]
#set_property PACKAGE_PIN D1 [get_ports loop_mgt_txn]

###############################################################################
# Timing Constraints
###############################################################################

create_clock -period 10.000 -name sys_clk [get_ports sys_clk_p]

###############################################################################
# Physical Constraints
###############################################################################

# Input reset is resynchronized within FPGA design as necessary
set_false_path -from [get_ports sys_rst_n]

#########################################################################################################################
# End PCIe Core Constraints
#########################################################################################################################


###############################################################################
# NanoEVB, PicoEVB common I/O
###############################################################################

set_property PACKAGE_PIN V14 [get_ports {status_leds[2]}]
set_property PACKAGE_PIN V13 [get_ports {status_leds[1]}]
set_property PACKAGE_PIN V12 [get_ports {status_leds[0]}]
set_property IOSTANDARD LVCMOS33 [get_ports {status_leds[2]}]
set_property IOSTANDARD LVCMOS33 [get_ports {status_leds[1]}]
set_property IOSTANDARD LVCMOS33 [get_ports {status_leds[0]}]
set_property PULLUP true [get_ports {status_leds[2]}]
set_property PULLUP true [get_ports {status_leds[1]}]
set_property PULLUP true [get_ports {status_leds[0]}]
set_property DRIVE 8 [get_ports {status_leds[2]}]
set_property DRIVE 8 [get_ports {status_leds[1]}]
set_property DRIVE 8 [get_ports {status_leds[0]}]

# clkreq_l is active low clock request for M.2 card to
# request PCI Express reference clock
set_property PACKAGE_PIN A9 [get_ports clkreq_l]
set_property IOSTANDARD LVCMOS33 [get_ports clkreq_l]
set_property PULLDOWN true [get_ports clkreq_l]

# Auxillary I/O Connector
# auxio[0] - conn pin 1
# auxio[1] - conn pin 2
# auxio[2] - conn pin 4
# auxio[3] - conn pin 5
# Note: These I/O may be re-purposed to use with XADC as analog inputs
set_property PACKAGE_PIN A14 [get_ports auxio_tri_io[0]]
set_property PACKAGE_PIN A13 [get_ports auxio_tri_io[1]]
set_property PACKAGE_PIN B12 [get_ports auxio_tri_io[2]]
set_property PACKAGE_PIN A12 [get_ports auxio_tri_io[3]]
set_property IOSTANDARD LVCMOS33 [get_ports auxio_tri_io[0]]
set_property IOSTANDARD LVCMOS33 [get_ports auxio_tri_io[1]]
set_property IOSTANDARD LVCMOS33 [get_ports auxio_tri_io[2]]
set_property IOSTANDARD LVCMOS33 [get_ports auxio_tri_io[3]]

###############################################################################
# PicoEVB-specific I/O
# Digital IO on PCIe edge connector (PicoEVB Rev.D and newer)
###############################################################################
set_property PACKAGE_PIN K2 [get_ports di_edge[0]]
set_property PACKAGE_PIN K1 [get_ports di_edge[1]]
set_property PACKAGE_PIN V2 [get_ports do_edge[0]]
set_property PACKAGE_PIN V3 [get_ports do_edge[1]]
set_property IOSTANDARD LVCMOS33 [get_ports di_edge[0]]
set_property IOSTANDARD LVCMOS33 [get_ports di_edge[1]]
set_property IOSTANDARD LVCMOS33 [get_ports do_edge[0]]
set_property IOSTANDARD LVCMOS33 [get_ports do_edge[1]]

###############################################################################
# SPI
###############################################################################
set_property PACKAGE_PIN K16 [get_ports {SPI_0_io0_io}]
set_property PACKAGE_PIN L17 [get_ports {SPI_0_io1_io}]
set_property PACKAGE_PIN J15 [get_ports {SPI_0_io2_io}]
set_property PACKAGE_PIN J16 [get_ports {SPI_0_io3_io}]
set_property PACKAGE_PIN L15 [get_ports {SPI_0_ss_io}]

set_property IOSTANDARD LVCMOS33 [get_ports {SPI_0_io0_io}]
set_property IOSTANDARD LVCMOS33 [get_ports {SPI_0_io1_io}]
set_property IOSTANDARD LVCMOS33 [get_ports {SPI_0_io2_io}]
set_property IOSTANDARD LVCMOS33 [get_ports {SPI_0_io3_io}]
set_property IOSTANDARD LVCMOS33 [get_ports {SPI_0_ss_io}]

#set_property PACKAGE_PIN L15 [get_ports {real_spi_ss}]
#set_property IOSTANDARD LVCMOS33 [get_ports {real_spi_ss}]


###############################################################################
# Additional design / project settings
###############################################################################

# Power down on overtemp
set_property BITSTREAM.CONFIG.OVERTEMPPOWERDOWN ENABLE [current_design]

# High-speed configuration so FPGA is up in time to negotiate with PCIe root complex
set_property BITSTREAM.CONFIG.CONFIGRATE 66 [current_design]
set_property BITSTREAM.CONFIG.SPI_BUSWIDTH 4 [current_design]
set_property CONFIG_MODE SPIx4 [current_design]
set_property BITSTREAM.CONFIG.SPI_FALL_EDGE YES [current_design]
set_property BITSTREAM.GENERAL.COMPRESS TRUE [current_design]

set_property CONFIG_VOLTAGE 3.3 [current_design]
set_property CFGBVS VCCO [current_design]
