RHSResearchLLC/PicoEVB/(commit log)

2017-06-09 Added GPLv2 licence to Xilinx driver code, per email from Xilinx Clarified compatible slots Added link to mPCIe->NGFF adapter
2017-06-21 Vivado project no longer stored as an archive, but rather in a format that is usable live
    [xilinx_xdma_pcie_x0y0.xdc]
2017-08-18 Added pre-built binaries suitable for downloading via cable Updated design to Gen 2
2017-09-15 Updated schematic and block diagram to include latest rev
2017-09-21 Move IP cache out of project folder (which gets regenerated every time project.tcl is sourced). Clean up some critical warnings for constraints that couldn't be applied correctly.
    [xilinx_xdma_pcie_x0y0.xdc]
2017-09-23 Minor updates: - Updated mcs with output from actual build - Added upgrade info to readme - Fixed some constraints to remove warnings
    [xilinx_xdma_pcie_x0y0.xdc]
2017-10-28 Changed PCIe reset to have internal pulldown- needed for consistent link on some motherboards Fixed mcs generation command Added new MCS built using 2017.3 & latest IP
    [xilinx_xdma_pcie_x0y0.xdc]
2017-11-19 SPI flash now set to load @ 66MHz (+-50%). This increased the chances that the FPGA is configured in time to be recognized as a PCIe endpoint
2017-11-28 Cleaned up block diagram: - Removed unused JTAG AXI - Improved PCIe status LED - Other LEDs now under SW control
2018-01-13 Adding helper script to build and install the driver for Linux. The driver will automatically loaded after the build, and reloaded on reboot
2018-01-15 Reorganizing to support more sample projects Added documentation for sample project 0 Added host code to sample project 0- demonstrates DMA transfer and blinking LEDs
2018-01-19 Moving Xilinx DMA driver to another location- its not really a part of this project Added licence files
2018-02-14 Schematic PDF is now searchable
2018-04-06 Added blurb for controlling LEDs for Windows users
2018-11-11 Adding Kicad project; changed licence to GPLv3
    [M2_edge_b.sch, PicoEVB.kicad_pcb, PicoEVB.sch, USB_IO_b.sch, fpga_io_b.sch, fpga_pcie_b.sch, fpga_pwr_cfg_b.sch, power_b.sch]
2019-11-21 Updated for Vivado 2019. Now works with latest Vivado drivers. Added XADC and support for flash programming over PCIe
2019-11-21 Adding script to report FPGA temperature and voltage
2020-11-30 Added OpenOCD programming instructions
    [flash.cfg, jtagspi.cfg, xilinx-xc7.cfg]
2021-11-13 Version 5: Built with Vivado 2021.1. Untested.
    [PicoEVB.csv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]
2025-12-04 Adding step file
    [PicoEVB.step]
